7kasper/LazerGamebox/hardware/reports/bom_preview.csv

Reference | Value | Footprint | LCSC Part # | Description | Qty
ANT401 | 868 spring | LazerGamebox_lcsc:ANT-TH_BW868SNX20-5Z6 | C496555 | BAT WIRELESS BW868SNX20-5Z6 spring antenna 868 MHz, THT pin | 1
ANT402 | GPS patch 18x18 | LazerGamebox_lcsc:ANT-TH_L18.0-W18.0_C9900026472 | C784395 | BAT WIRELESS BWGNSCNX18-18W4 ceramic patch antenna 1575 MHz, THT pin | 1
BT101,BT102 | 18650 | LazerGamebox_lcsc:BATTERY-SMD_18650-1S-L77.1-W20.7-1 | C2988620 | MYOUNG BH-18650-B1BA002 SMT 18650 holder, gold contacts | 2
C101,C121,C203-C205,C504,C508,C509,C511,C513,C514,C517 | 1uF | Capacitor_SMD:C_0603_1608Metric | C15849 | Unpolarized capacitor | 12
C102,C105,C108,C110,C115,C118-C120,C201,C207,C304,C403,C406,C506,C601 | 10uF | Capacitor_SMD:C_0805_2012Metric | C15850 | Unpolarized capacitor | 15
C103,C106,C114,C122,C202,C206,C208,C209,C305,C404,C407,C501-C503,C507,C602-C609,C611 | 100nF | Capacitor_SMD:C_0603_1608Metric | C14663 | Unpolarized capacitor | 24
C107,C109,C111,C112 | 22uF | Capacitor_SMD:C_0805_2012Metric | C45783 | Unpolarized capacitor | 4
C113,C510 | 1nF | Capacitor_SMD:C_0603_1608Metric | C1588 | Unpolarized capacitor | 2
C116,C512,C610 | 4.7uF | Capacitor_SMD:C_0603_1608Metric | C19666 | Unpolarized capacitor | 3
C117 | 47nF | Capacitor_SMD:C_0603_1608Metric | C1622 | Unpolarized capacitor | 1
C303,C505 | 470uF | Capacitor_SMD:CP_Elec_6.3x7.7 | C2858856 | 470 uF 10 V SMD electrolytic | 2
C405,C516 | 100pF | Capacitor_SMD:C_0603_1608Metric | C14858 | Unpolarized capacitor | 2
D101 | USBLC6-2SC6 | Package_TO_SOT_SMD:SOT-23-6 | C7519 | Very low capacitance ESD protection diode, 2 data-line, SOT-23-6 | 1
D102 | RED CHRG | LED_SMD:LED_0603_1608Metric | C2286 | KENTO KT-0603R red LED | 1
D601-D603 | WS2812B-2020 | LazerGamebox:LED_WS2812B-2020_PLCC4_2.0x2.0mm | C52917434 | Worldsemi WS2812B-2020-V6 addressable RGB LED | 3
D604 | VSMY2940G | LazerGamebox_lcsc:LED-SMD_L2.3-W2.3-RD_VSMY2940G | C499547 | Vishay VSMY2940G 940 nm IR emitter, 75 mW/sr at 100 mA | 1
D605,D606 | SS34 | Diode_SMD:D_SMA | C8678 | Schottky diode | 2
J101 | USB-C 16P | LazerGamebox:USB_C_Receptacle_HRO_TYPE-C-31-M-12 | C165948 | Korean Hroparts TYPE-C-31-M-12, 16 pin USB 2.0 receptacle | 1
J301 | SMA | LazerGamebox:SMA_BAT_Wireless_BWSMA-KWE-Z001 | C496551 | BAT WIRELESS BWSMA-KWE-Z001 right-angle SMA, THT | 1
J601 | ZIF 12P 0.5mm | LazerGamebox_lcsc:FPC-SMD_12P-P0.50_05A20H12P | C5362174 | HanElectricity 05A20H12P dual-contact ZIF for HS20HS072RX (C5329582) panel | 1
J602 | EXPANSION 2x10 | Connector_PinHeader_2.54mm:PinHeader_2x10_P2.54mm_Vertical | C5383109 | HanElectricity 2541WV-2x10P 2.54 mm pin header, THT | 1
L101-L103 | 1uH | Inductor_SMD:L_Sunlord_SWPA4030S | C42193 | Sunlord SWPA4030S1R0NT 1 uH, Isat 5.7 A | 3
LS501 | FS-3013 30mm 8R | LazerGamebox_lcsc:BEEP-TH_BD30.0-P15.00-D1.0 | C482323 | FUET FS-3013 30 mm 8 ohm 1 W speaker, THT | 1
MK501 | MSM421ACT006 | LazerGamebox_lcsc:MIC-SMD_4P-L2.8-W1.9-P1.01-TL | C51928207 | MEMSensing MSM421ACT006 analog top-port MEMS microphone, -42 dBV/Pa, 1.5 to 3.6 V, LGA-4 | 1
Q101 | FS8205A | Package_TO_SOT_SMD:SOT-23-6 | C908265 | FUXINSEMI FS8205A dual N-channel MOSFET 20 V 6 A, common drain, SOT-23-6 | 1
Q103,Q105,Q107 | AO3401A | Package_TO_SOT_SMD:SOT-23 | C15127 | -4.0A Id, -30V Vds, P-Channel MOSFET, SOT-23 | 3
Q104,Q106,Q108,Q301,Q501 | 2N7002 | Package_TO_SOT_SMD:SOT-23 | C8545 | 0.115A Id, 60V Vds, N-Channel MOSFET, SOT-23,2N7002 N-MOSFET, mic mute | 5
Q201,Q202,Q601,Q602 | SS8050 | Package_TO_SOT_SMD:SOT-23 | C2150 | General Purpose NPN Transistor, 1.5A Ic, 25V Vce, SOT-23 | 4
Q603,Q604 | AO3400A | Package_TO_SOT_SMD:SOT-23 | C20917 | AOS AO3400A N-MOSFET 5.7 A, 30 mR, low-side driver | 2
R101-R103,R105,R116,R118,R120,R122,R201-R205,R208,R302,R410,R510,R511,R521,R603,R606,R609,R610 | 10k | Resistor_SMD:R_0603_1608Metric | C25804 | Resistor | 23
R104,R107,R210,R211,R306,R411,R501,R506,R512,R516,R602 | 1k | Resistor_SMD:R_0603_1608Metric | C21190 | Resistor | 11
R106,R605 | 100R | Resistor_SMD:R_0603_1608Metric | C22775 | Resistor | 2
R111 | 150k | Resistor_SMD:R_0603_1608Metric | C22807 | Resistor | 1
R112,R114 | 33k | Resistor_SMD:R_0603_1608Metric | C4216 | Resistor | 2
R113,R502,R503 | 220k | Resistor_SMD:R_0603_1608Metric | C22961 | Resistor | 3
R115,R117,R119,R304,R305,R504,R505,R508,R509,R517-R519 | 100k | Resistor_SMD:R_0603_1608Metric | C25803 | Resistor | 12
R121,R206,R207,R513,R514 | 4.7k | Resistor_SMD:R_0603_1608Metric | C23162 | Resistor | 5
R123,R209,R301,R401,R412 | 0R | Resistor_SMD:R_0603_1608Metric | C21189 | Resistor | 5
R125,R126,R604,R608 | 330R | Resistor_SMD:R_0603_1608Metric | C23138 | Resistor | 4
R303,R515 | 22k | Resistor_SMD:R_0603_1608Metric | C31850 | Resistor | 2
R507 | 47k | Resistor_SMD:R_0603_1608Metric | C25819 | Resistor | 1
R520 | 470k | Resistor_SMD:R_0603_1608Metric | C23164 | Resistor | 1
R601 | 20R | Resistor_SMD:R_0805_2012Metric | C17544 | Resistor | 1
R607 | 12R | Resistor_SMD:R_1206_3216Metric | C17913 | Resistor | 1
RV601 | 10k lin | LazerGamebox_lcsc:Potentiometer_Alps_RK09K1130A6S_LCSC | C209770 | Alps RK09K1130A6S 10k linear, 15 mm flat shaft, THT | 1
SW101 | PWR | LazerGamebox:SW_Push_1P1T_XKB_TS-1187A | C318884 | XKB TS-1187A-B-A-B 5.1 mm tact switch | 1
SW201 | RESET | LazerGamebox:SW_Push_1P1T_XKB_TS-1187A | C318884 | XKB TS-1187A-B-A-B 5.1 mm tact switch | 1
SW202 | BOOT | LazerGamebox:SW_Push_1P1T_XKB_TS-1187A | C318884 | XKB TS-1187A-B-A-B 5.1 mm tact switch | 1
SW601 | BTN1 | LazerGamebox:SW_Push_1P1T_XKB_TS-1187A | C318884 | XKB TS-1187A-B-A-B 5.1 mm tact switch | 1
SW602 | BTN2 | LazerGamebox:SW_Push_1P1T_XKB_TS-1187A | C318884 | XKB TS-1187A-B-A-B 5.1 mm tact switch | 1
SW603 | BTN3 | LazerGamebox:SW_Push_1P1T_XKB_TS-1187A | C318884 | XKB TS-1187A-B-A-B 5.1 mm tact switch | 1
U101 | BQ25601 | LazerGamebox_lcsc:VFQFPN-24_L4.0-W4.0-P0.50-BL-EP2.8 | C468236 | TI BQ25601 3 A I2C 1S switching charger with NVDC power path and ship mode, WQFN-24 | 1
U102 | DW01A | Package_TO_SOT_SMD:SOT-23-6 | C351410 | PUOLOP DW01A single cell protection IC | 1
U103 | TPS62A02 | Package_TO_SOT_SMD:SOT-563 | C5350187 | TI TPS62A02DRLR 2 A synchronous buck, SOT-563 | 1
U104 | TPS61023 | Package_TO_SOT_SMD:SOT-563 | C919459 | TI TPS61023 synchronous boost converter, 3.7 A switch, true disconnect, SOT-563 | 1
U105 | HUSB238 | LazerGamebox_lcsc:DFN-10_L3.0-W3.0-P0.50-BL-EP2.5 | C7471904 | Hynetek HUSB238 USB PD sink controller with I2C source-capability readback, DFN-10 | 1
U106 | MAX17048 | LazerGamebox_lcsc:TDFN-8_L2.0-W2.0-P0.50-BL-EP1.2 | C2682616 | Maxim MAX17048 ModelGauge 1S fuel gauge, I2C 0x36, TDFN-8 2x2 | 1
U201 | ESP32-WROOM-32E-N16 | RF_Module:ESP32-WROOM-32E | C701343 | Espressif ESP32-WROOM-32E-N16 module | 1
U202 | XC6206P332MR | Package_TO_SOT_SMD:SOT-23-3 | C5446 | Torex XC6206P332MR 3.3 V 250 mA LDO | 1
U203 | CH340C | Package_SO:SOIC-16_3.9x9.9mm_P1.27mm | C84681 | WCH CH340C USB to UART bridge with internal oscillator, SOIC-16 | 1
U204 | LIS3DHTR | Package_LGA:LGA-16_3x3mm_P0.5mm_LayoutBorder3x5y | C15134 | ST LIS3DHTR 3-axis accelerometer, LGA-16 | 1
U205,U602 | TCA9555PWR | Package_SO:TSSOP-24_4.4x7.8mm_P0.65mm | C465732 | TI TCA9555PWR 16-bit I2C GPIO expander with interrupt | 2
U301 | SA818S-U | LazerGamebox_lcsc:WIRELM-SMD_G-NICERF_SA818S-X | C3001549 | G-NiceRF SA818S-U 1 W UHF walkie-talkie module, 400-480 MHz, UART control | 1
U401 | Ra-01SH | LazerGamebox_lcsc:WIRELM-SMD_RA-01SH | C2764087 | Ai-Thinker Ra-01SH SX1262 LoRa module 803-930 MHz, SPI | 1
U402 | ATGM336H-5N31 | LazerGamebox_lcsc:GPSM-SMD_ATGM336H-TR | C90770 | ZHONGKEWEI ATGM336H-5N31 GNSS module (GPS/BDS/GLONASS), UART, 1PPS | 1
U501,U503 | TS5A3159 | Package_TO_SOT_SMD:SOT-363_SC-70-6 | C46388 | TI TS5A3159 1 ohm SPDT analog switch, SC-70-6 | 2
U502 | NS4150B | Package_SO:MSOP-8_3x3mm_P0.65mm | C189961 | Nsiway NS4150B 3 W mono class-D audio amplifier, MSOP-8 | 1
U504 | LMV321 | Package_TO_SOT_SMD:SOT-23-5 | C7972 | TI LMV321 rail-to-rail op amp, 1 MHz GBW, SOT-23-5 | 1
U601 | IRM-H638T | LazerGamebox:Everlight_IRM-H6xxT | C91447 | Everlight IRM-H638T/TR2 38 kHz IR receiver module, SMD | 1
