7kasper/LazerGamebox/hardware/reports/LazerGamebox_schematic.pdf

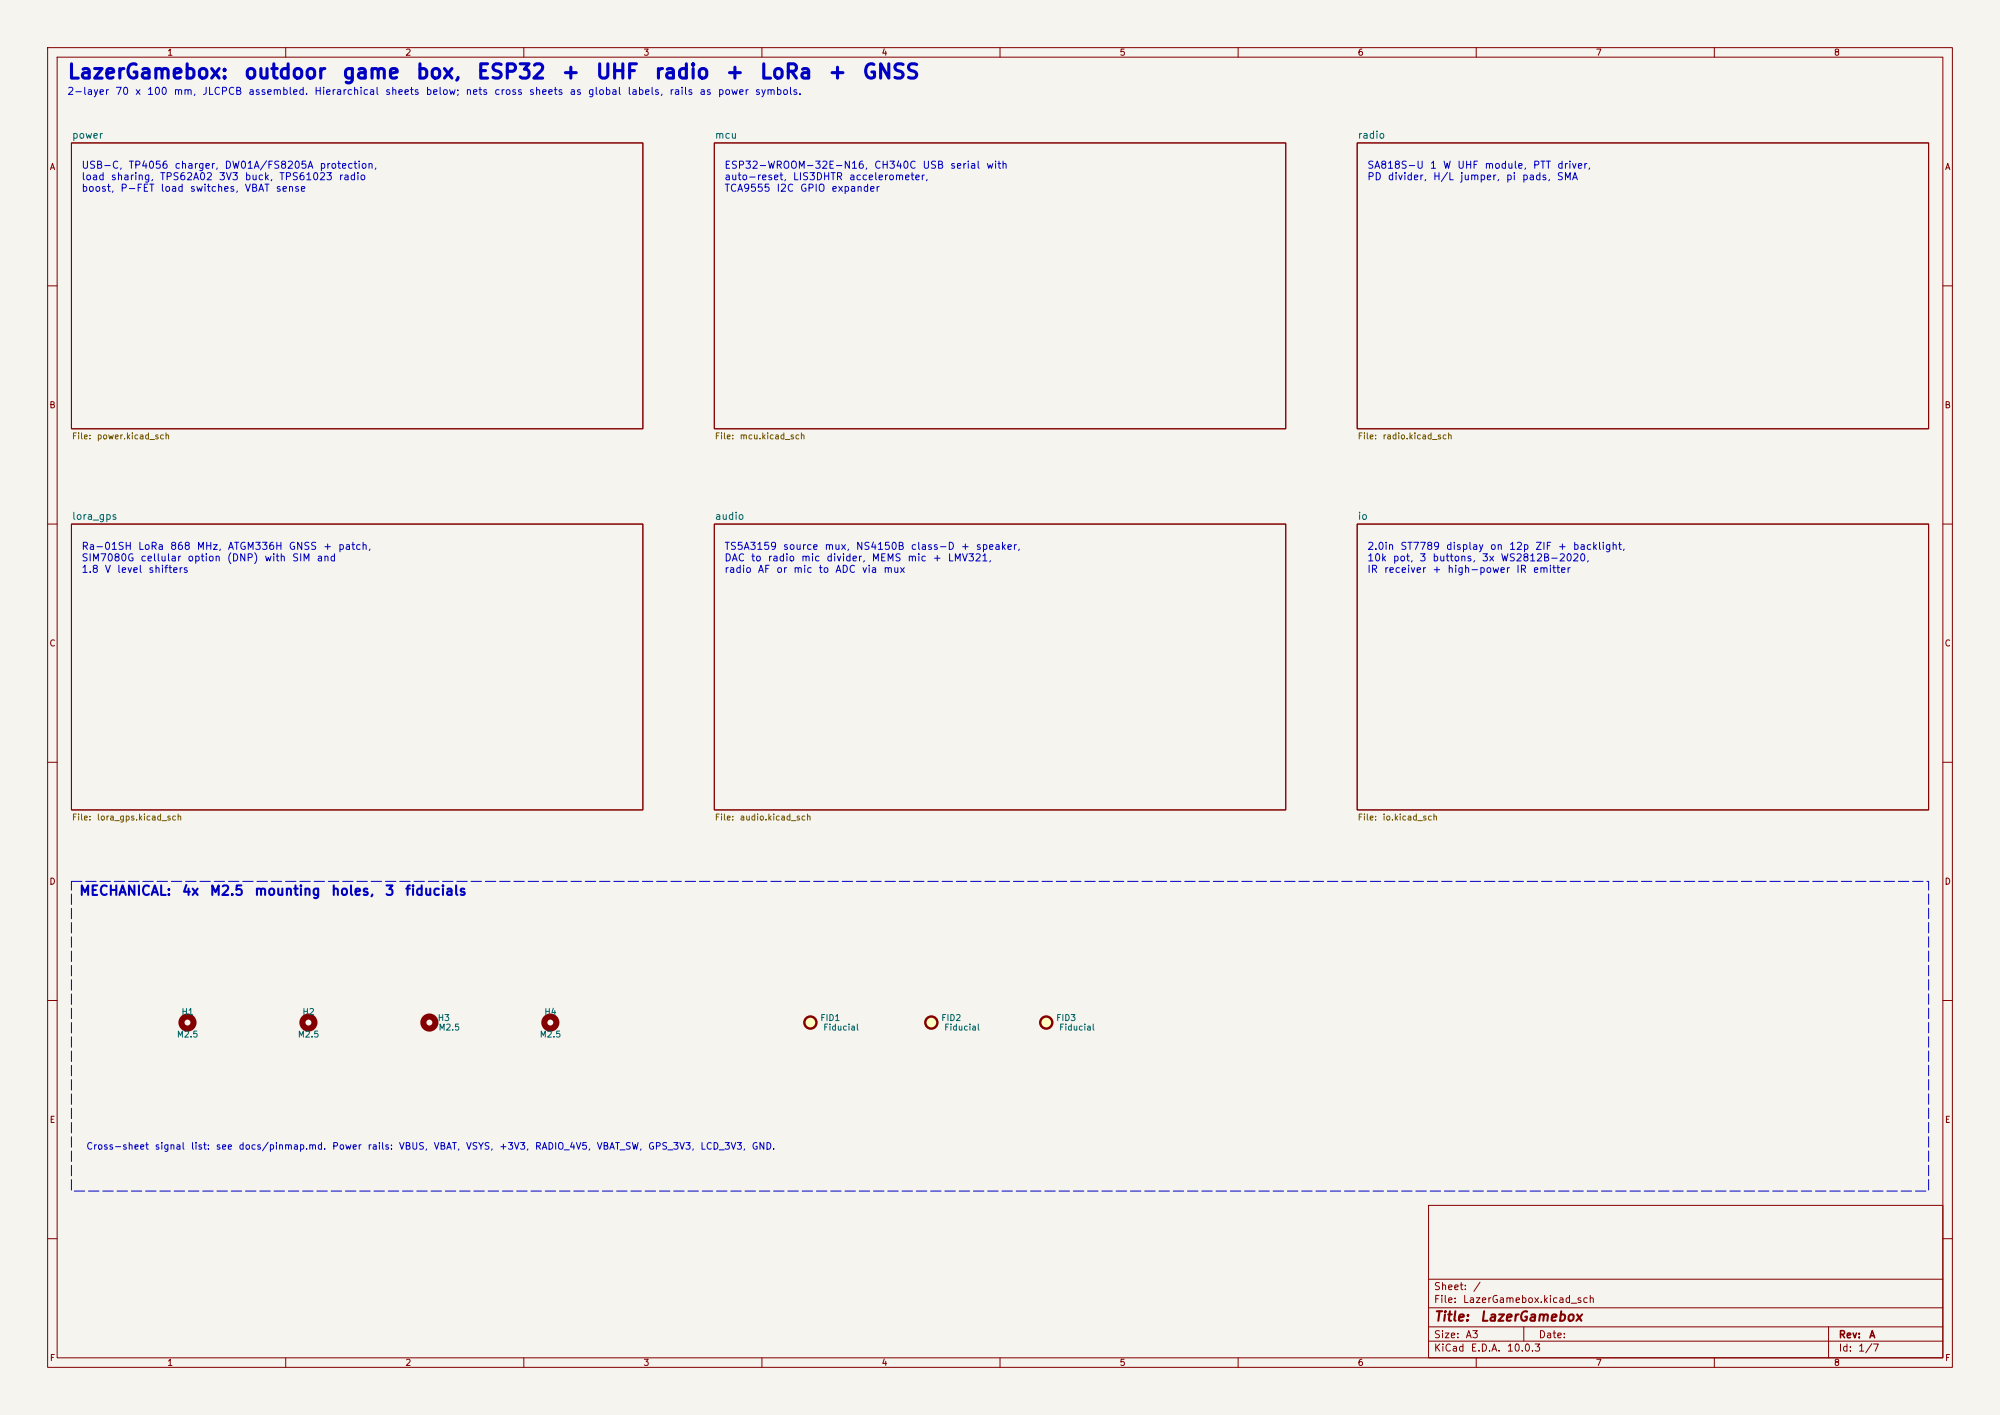
[picture p1: page 1]

LazerGamebox: outdoor game box, ESP32 + UHF radio + LoRa + GNSS

2-layer 70 x 100 mm, JLCPCB assembled. Hierarchical sheets below; nets cross sheets as global labels, rails as power symbols.

USB-C, TP4056 charger, DW01A/FS8205A protection,
load sharing, TPS62A02 3V3 buck, TPS61023 radio

SA818S-U 1 W UHF module, PTT driver,
PD divider, H/L jumper, pi pads, SMA

Ra-01SH LoRa 868 MHz, ATGM336H GNSS + patch,
SIM7080G cellular option (DNP) with SIM and
1.8 V level shifters

TS5A3159 source mux, NS4150B class-D + speaker,
DAC to radio mic divider, MEMS mic + LMV321,

10k pot, 3 buttons, 3x WS2812B-2020,
IR receiver + high-power IR emitter

MECHANICAL: 4x M2.5 mounting holes, 3 fiducials

Cross-sheet signal list: see docs/pinmap.md. Power rails: VBUS, VBAT, VSYS, +3V3, RADIO_4V5, VBAT_SW, GPS_3V3, LCD_3V3, GND.

Size: A3 | Rev: A | F Date:
KiCad E.D.A. 10.0.3 | Id: 1/7

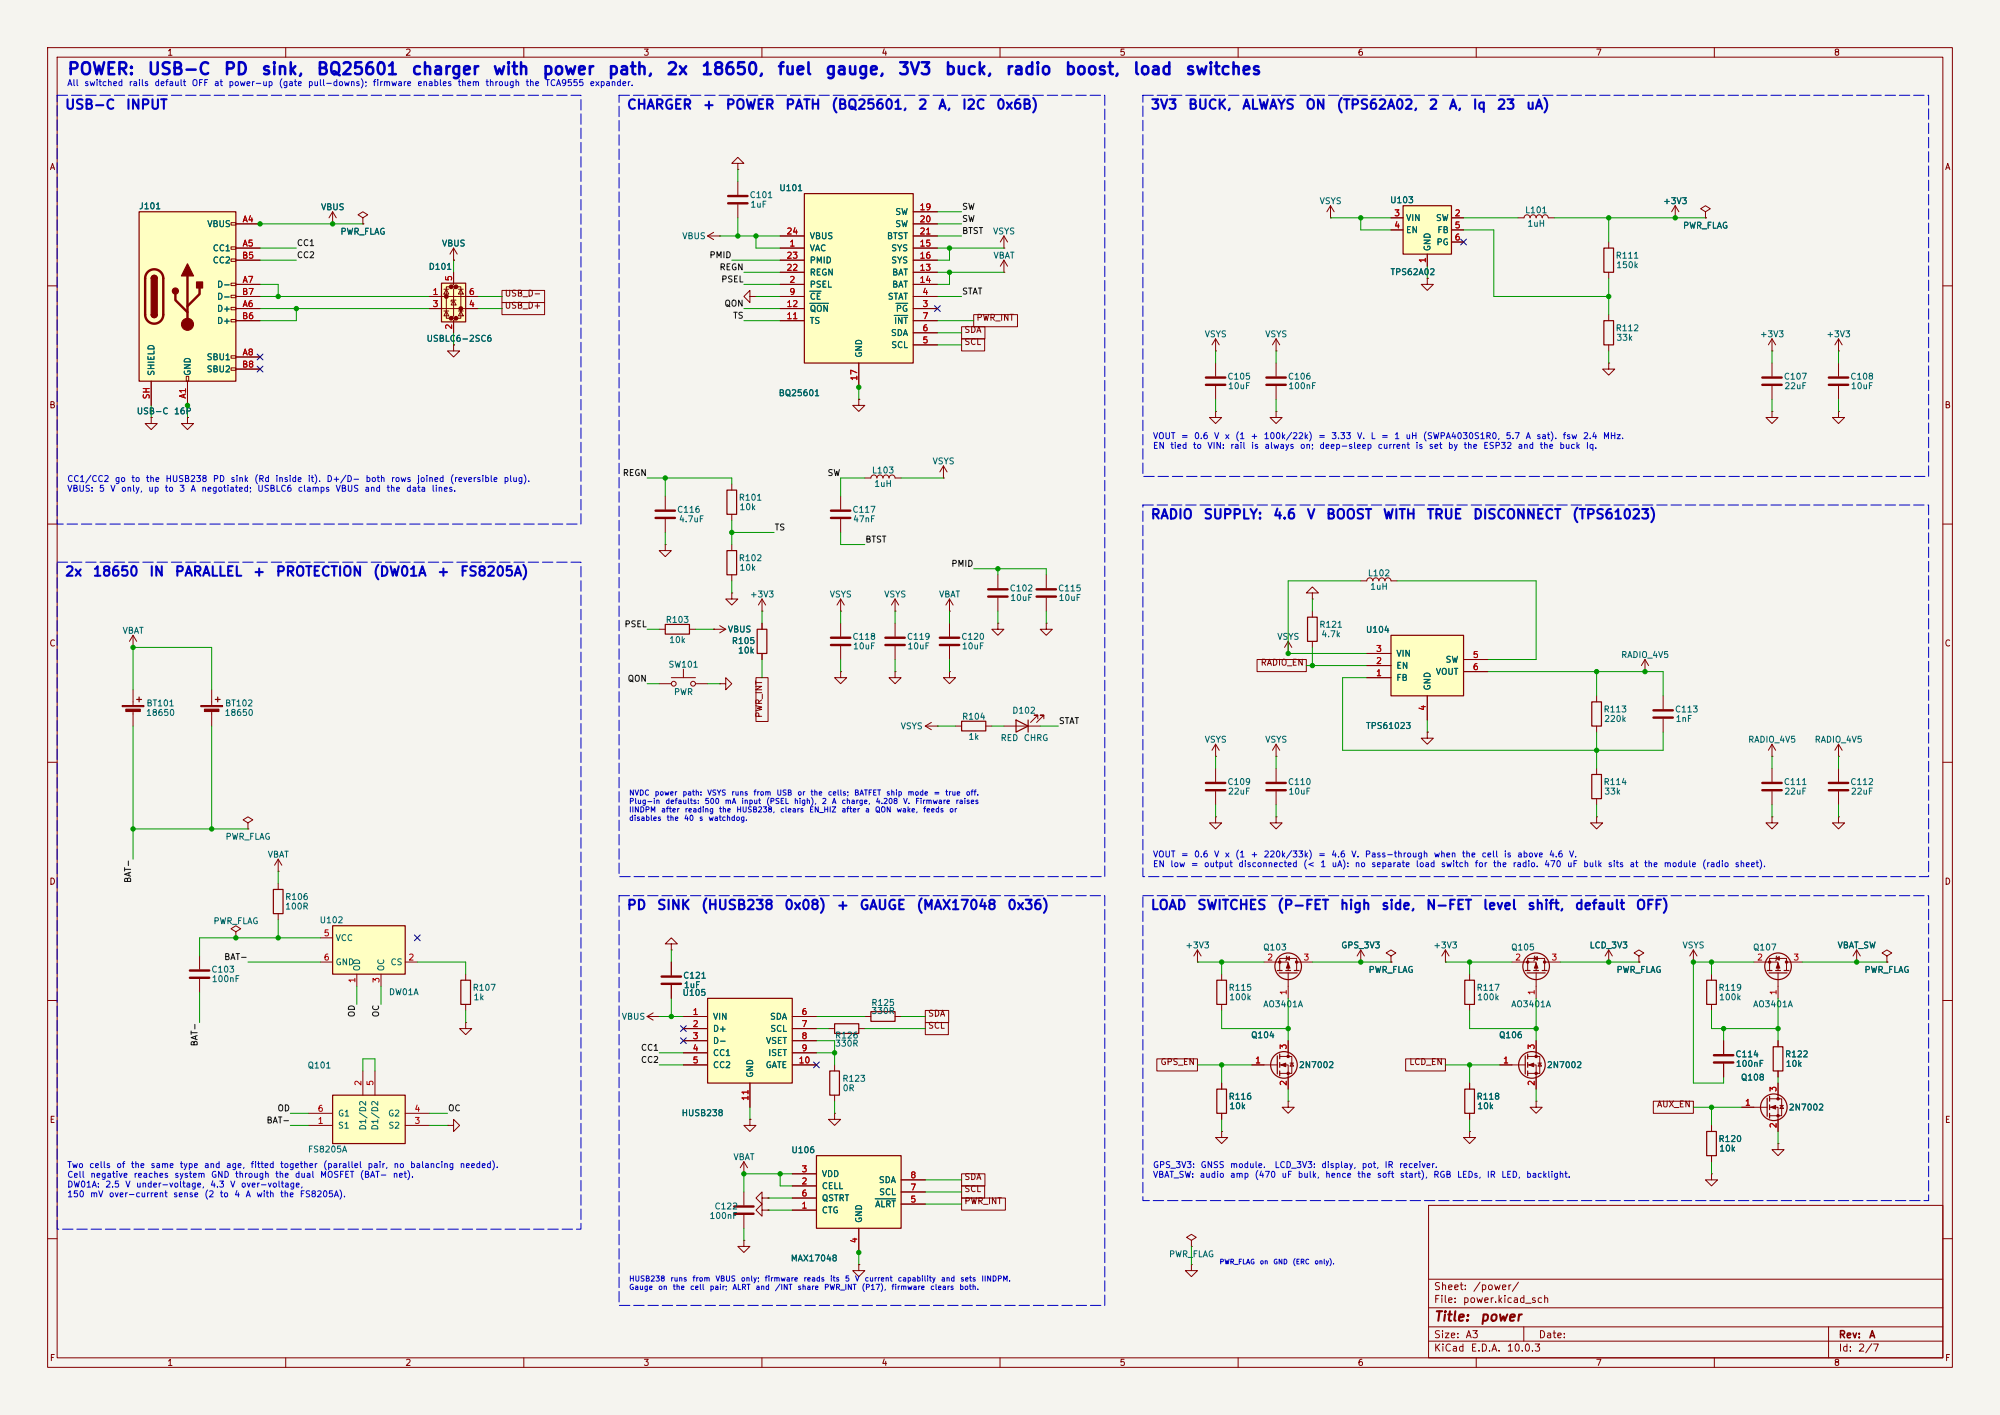
[picture p2: page 2]

POWER: USB-C PD sink, BQ25601 charger with power path, 2x 18650, fuel gauge, 3V3 buck, radio boost, load switches
All switched rails default OFF at power-up (gate pull-downs); firmware enables them through the TCA9555 expander.
USB-C INPUT
J101 USB-C 16P

3V3 BUCK, ALWAYS ON (TPS62A02, 2 A, Iq 23 uA)

VOUT = 0.6 V x (1 + 100k/22k) = 3.33 V. L = 1 uH (SWPA4030S1R0, 5.7 A sat). fsw 2.4 MHz. EN tied to VIN: rail is always on; deep-sleep current is set by the ESP32 and the buck Iq.

CC1/CC2 go to the HUSB238 PD sink (Rd inside it). D+/D- both rows joined (reversible plug). VBUS: 5 V only, up to 3 A negotiated; USBLC6 clamps VBUS and the data lines. 2x 18650 IN PARALLEL + PROTECTION (DW01A + FS8205A)

RADIO SUPPLY: 4.6 V BOOST WITH TRUE DISCONNECT (TPS61023)

NVDC power path: VSYS runs from USB or the cells; BATFET ship mode = true off. Plug-in defaults: 500 mA input (PSEL high), 2 A charge, 4.208 V. Firmware raises

IINDPM after reading the HUSB238, clears EN_HIZ after a QON wake, feeds or disables the 40 s watchdog.

VOUT = 0.6 V x (1 + 220k/33k) = 4.6 V. Pass-through when the cell is above 4.6 V. EN low = output disconnected (< 1 uA): no separate load switch for the radio. 470 uF bulk sits at the module (radio sheet).

LOAD SWITCHES (P-FET high side, N-FET level shift, default OFF)

GPS_3V3: GNSS module. LCD_3V3: display, pot, IR receiver. VBAT_SW: audio amp (470 uF bulk, hence the soft start), RGB LEDs, IR LED, backlight.

HUSB238 runs from VBUS only; firmware reads its 5 V current capability and sets IINDPM. Gauge on the cell pair; ALRT and /INT share PWR_INT (P17), firmware clears both.

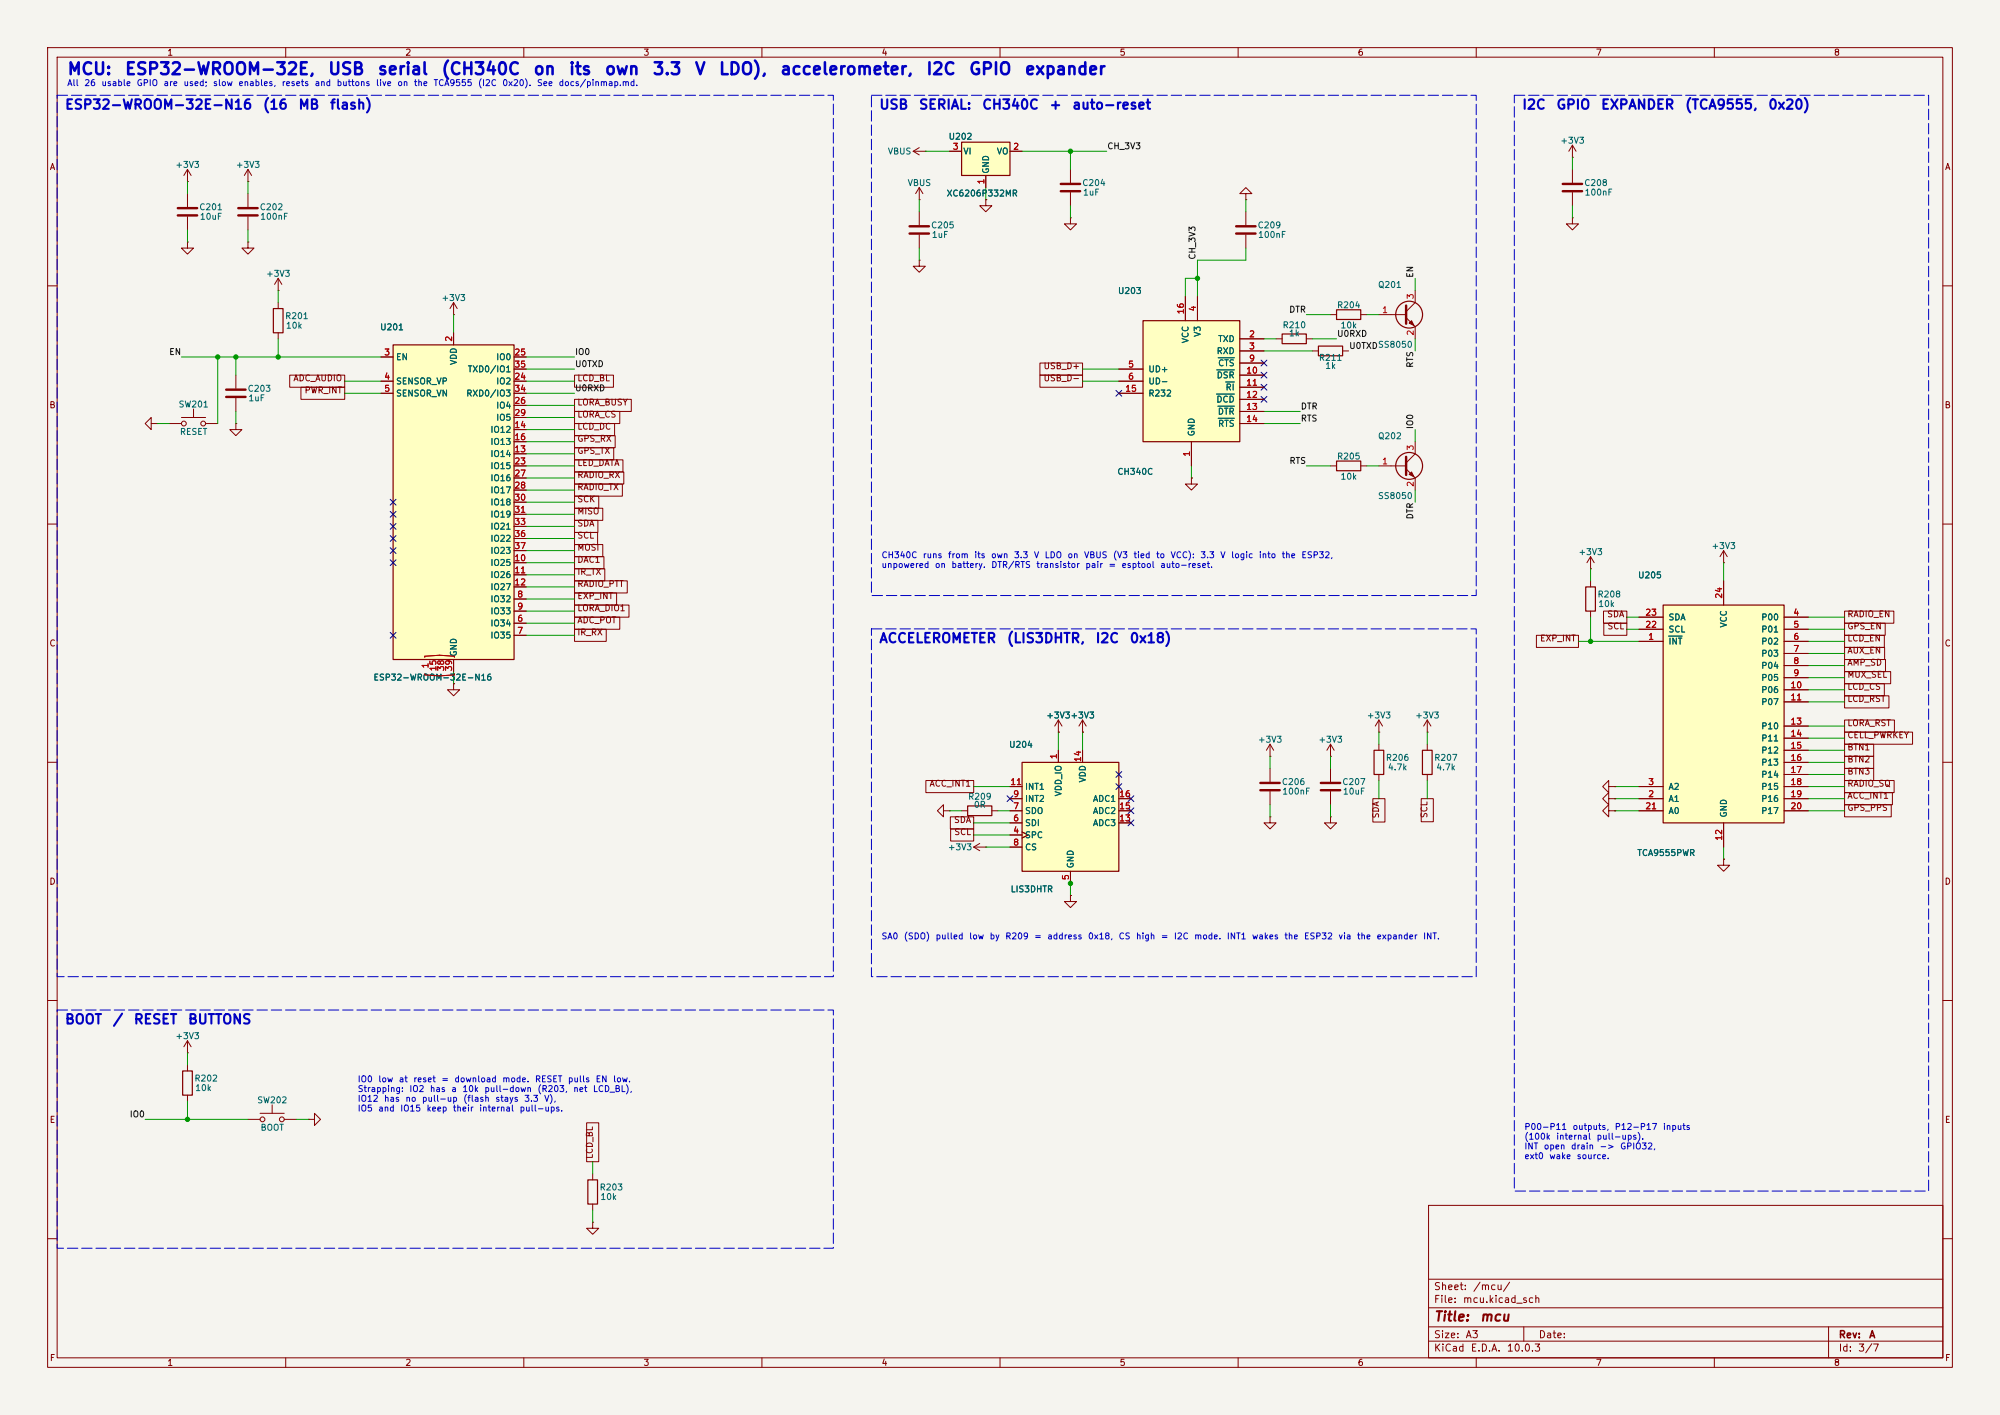
[picture p3: page 3]

MCU: ESP32-WROOM-32E, USB serial (CH340C on its own 3.3 V LDO), accelerometer, I2C GPIO expander
All 26 usable GPIO are used; slow enables, resets and buttons live on the TCA9555 (I2C 0x20). See docs/pinmap.md.

USB SERIAL: CH340C + auto-reset

4 UD+ 5 UD- 6 CTS 9 DSR 10 RI 11 DCD 12 DTR 13 RTS 14 R232 15 VCC 16 U203 CH340C

4 UD+ 5 UD- 6 CTS 9 DSR 10 RI 11 DCD 12 DTR 13 RTS 14 R232 15 VCC 16 U204

CH340C runs from its own 3.3 V LDO on VBUS (V3 tied to VCC): 3.3 V logic into the ESP32,
unpowered on battery. DTR/RTS transistor pair = esptool auto-reset. ACCELEROMETER (LIS3DHTR, I2C 0x18)

SA0 (SDO) pulled low by R209 = address 0x18, CS high = I2C mode. INT1 wakes the ESP32 via the expander INT. BOOT / RESET BUTTONS

IO0 low at reset = download mode. RESET pulls EN low. Strapping: IO2 has a 10k pull-down (R203, net LCD_BL),

IO12 has no pull-up (flash stays 3.3 V),
IO5 and IO15 keep their internal pull-ups.

P00-P11 outputs, P12-P17 inputs
(100k internal pull-ups).
INT open drain -> GPIO32, ext0 wake source.

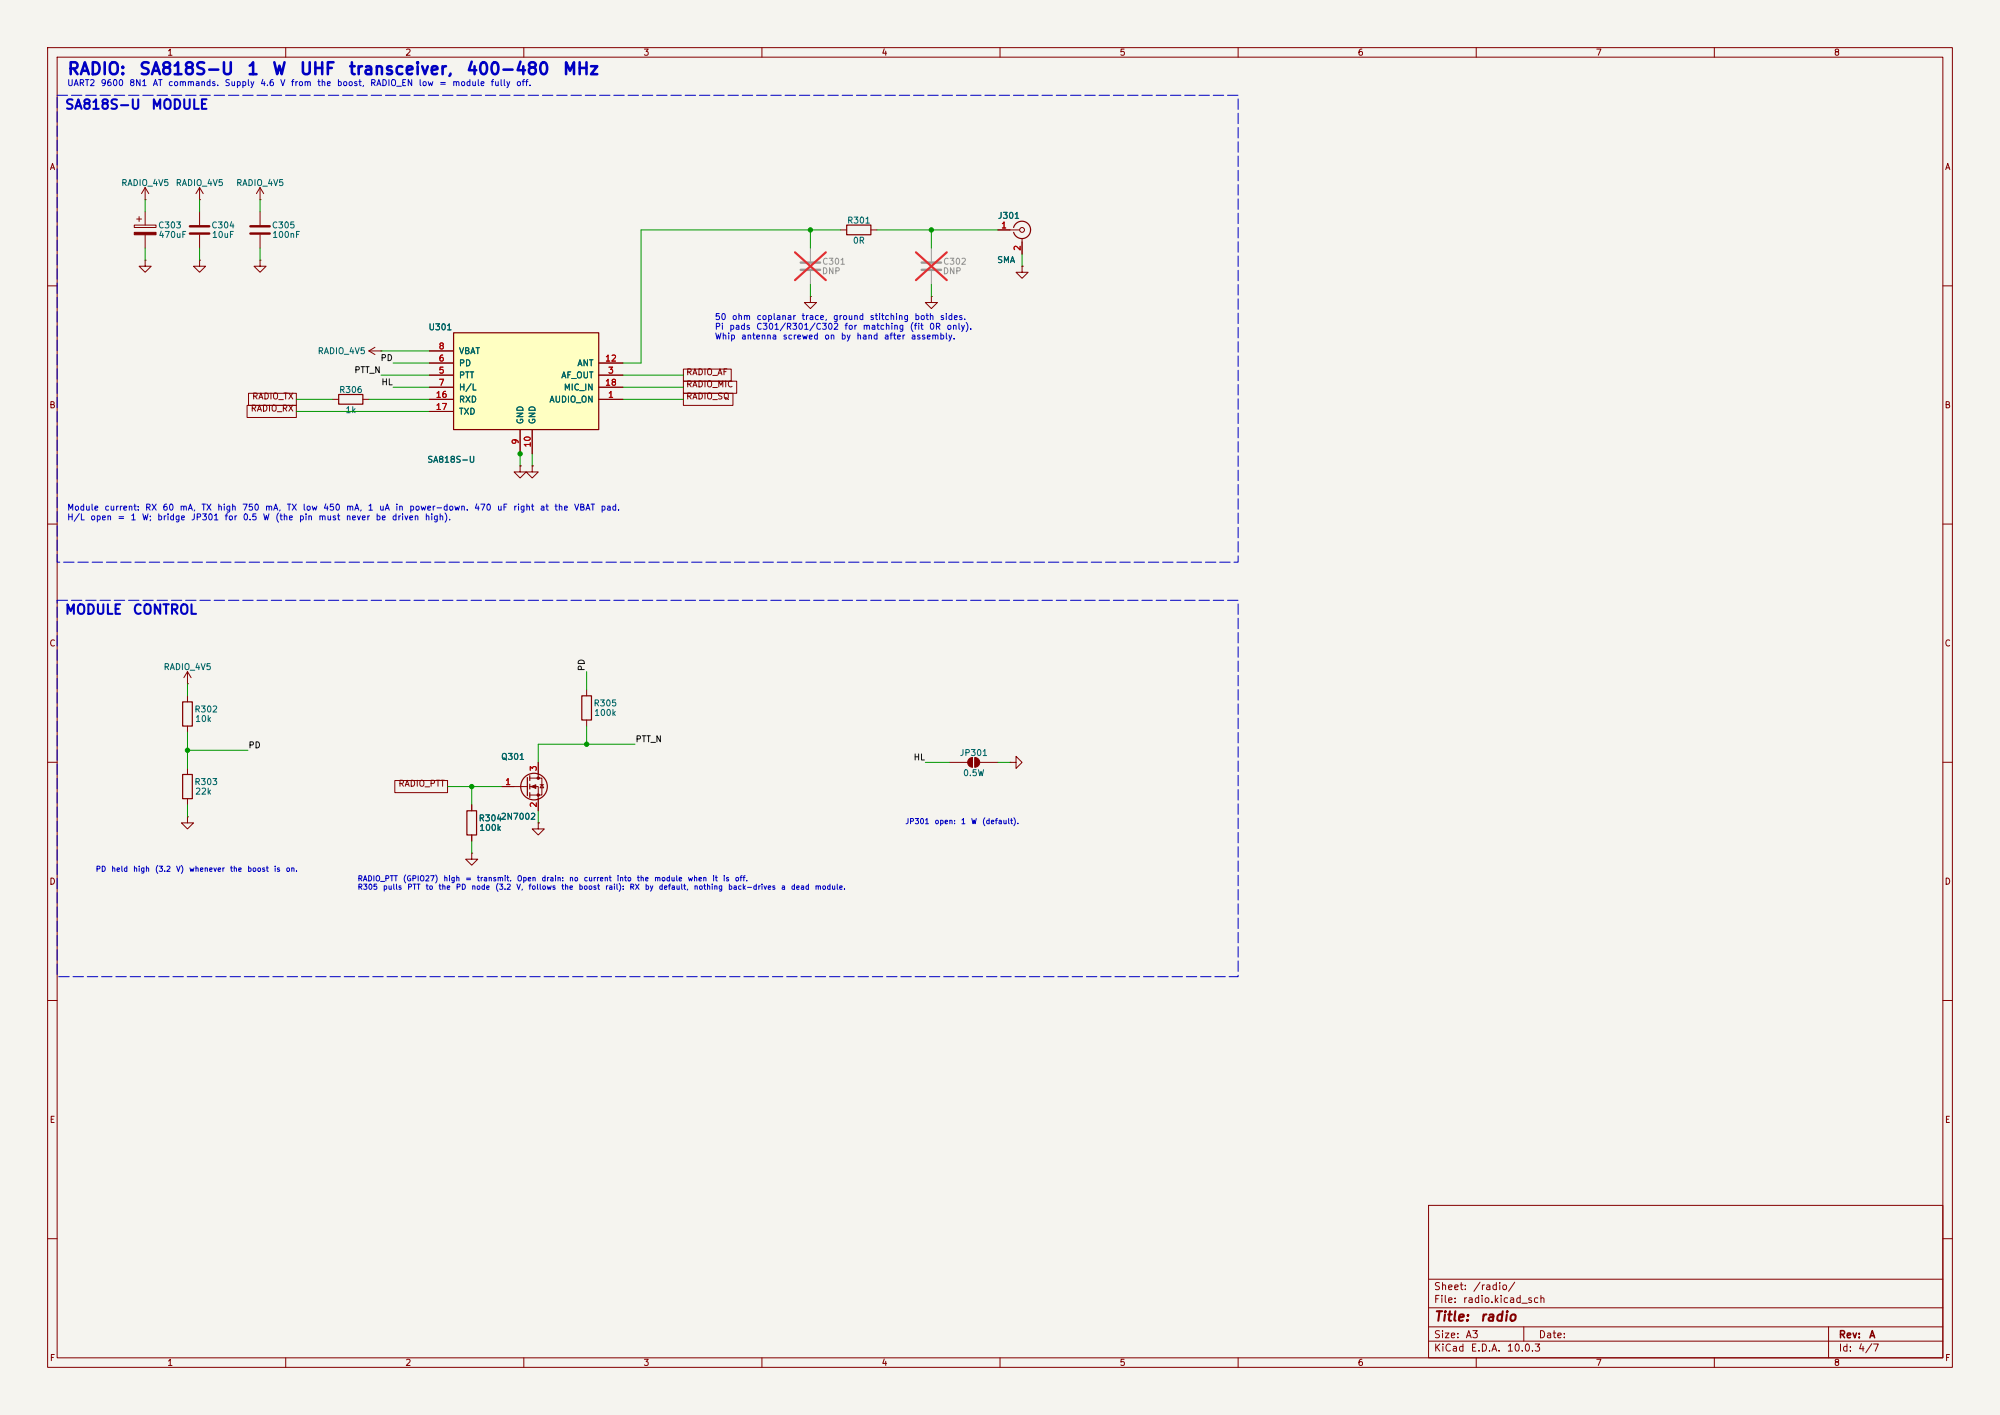
[picture p4: page 4]

RADIO: SA818S-U 1 W UHF transceiver, 400-480 MHz
UART2 9600 8N1 AT commands. Supply 4.6 V from the boost, RADIO_EN low = module fully off.
SA818S-U MODULE

50 ohm coplanar trace, ground stitching both sides. Pi pads C301/R301/C302 for matching (fit 0R only).

Whip antenna screwed on by hand after assembly.

Module current: RX 60 mA, TX high 750 mA, TX low 450 mA, 1 uA in power-down. 470 uF right at the VBAT pad.
H/L open = 1 W; bridge JP301 for 0.5 W (the pin must never be driven high).

JP301 open: 1 W (default). RADIO_PTT (GPIO27) high = transmit. Open drain: no current into the module when it is off. R305 pulls PTT to the PD node (3.2 V, follows the boost rail): RX by default, nothing back-drives a dead module.

PD held high (3.2 V) whenever the boost is on.

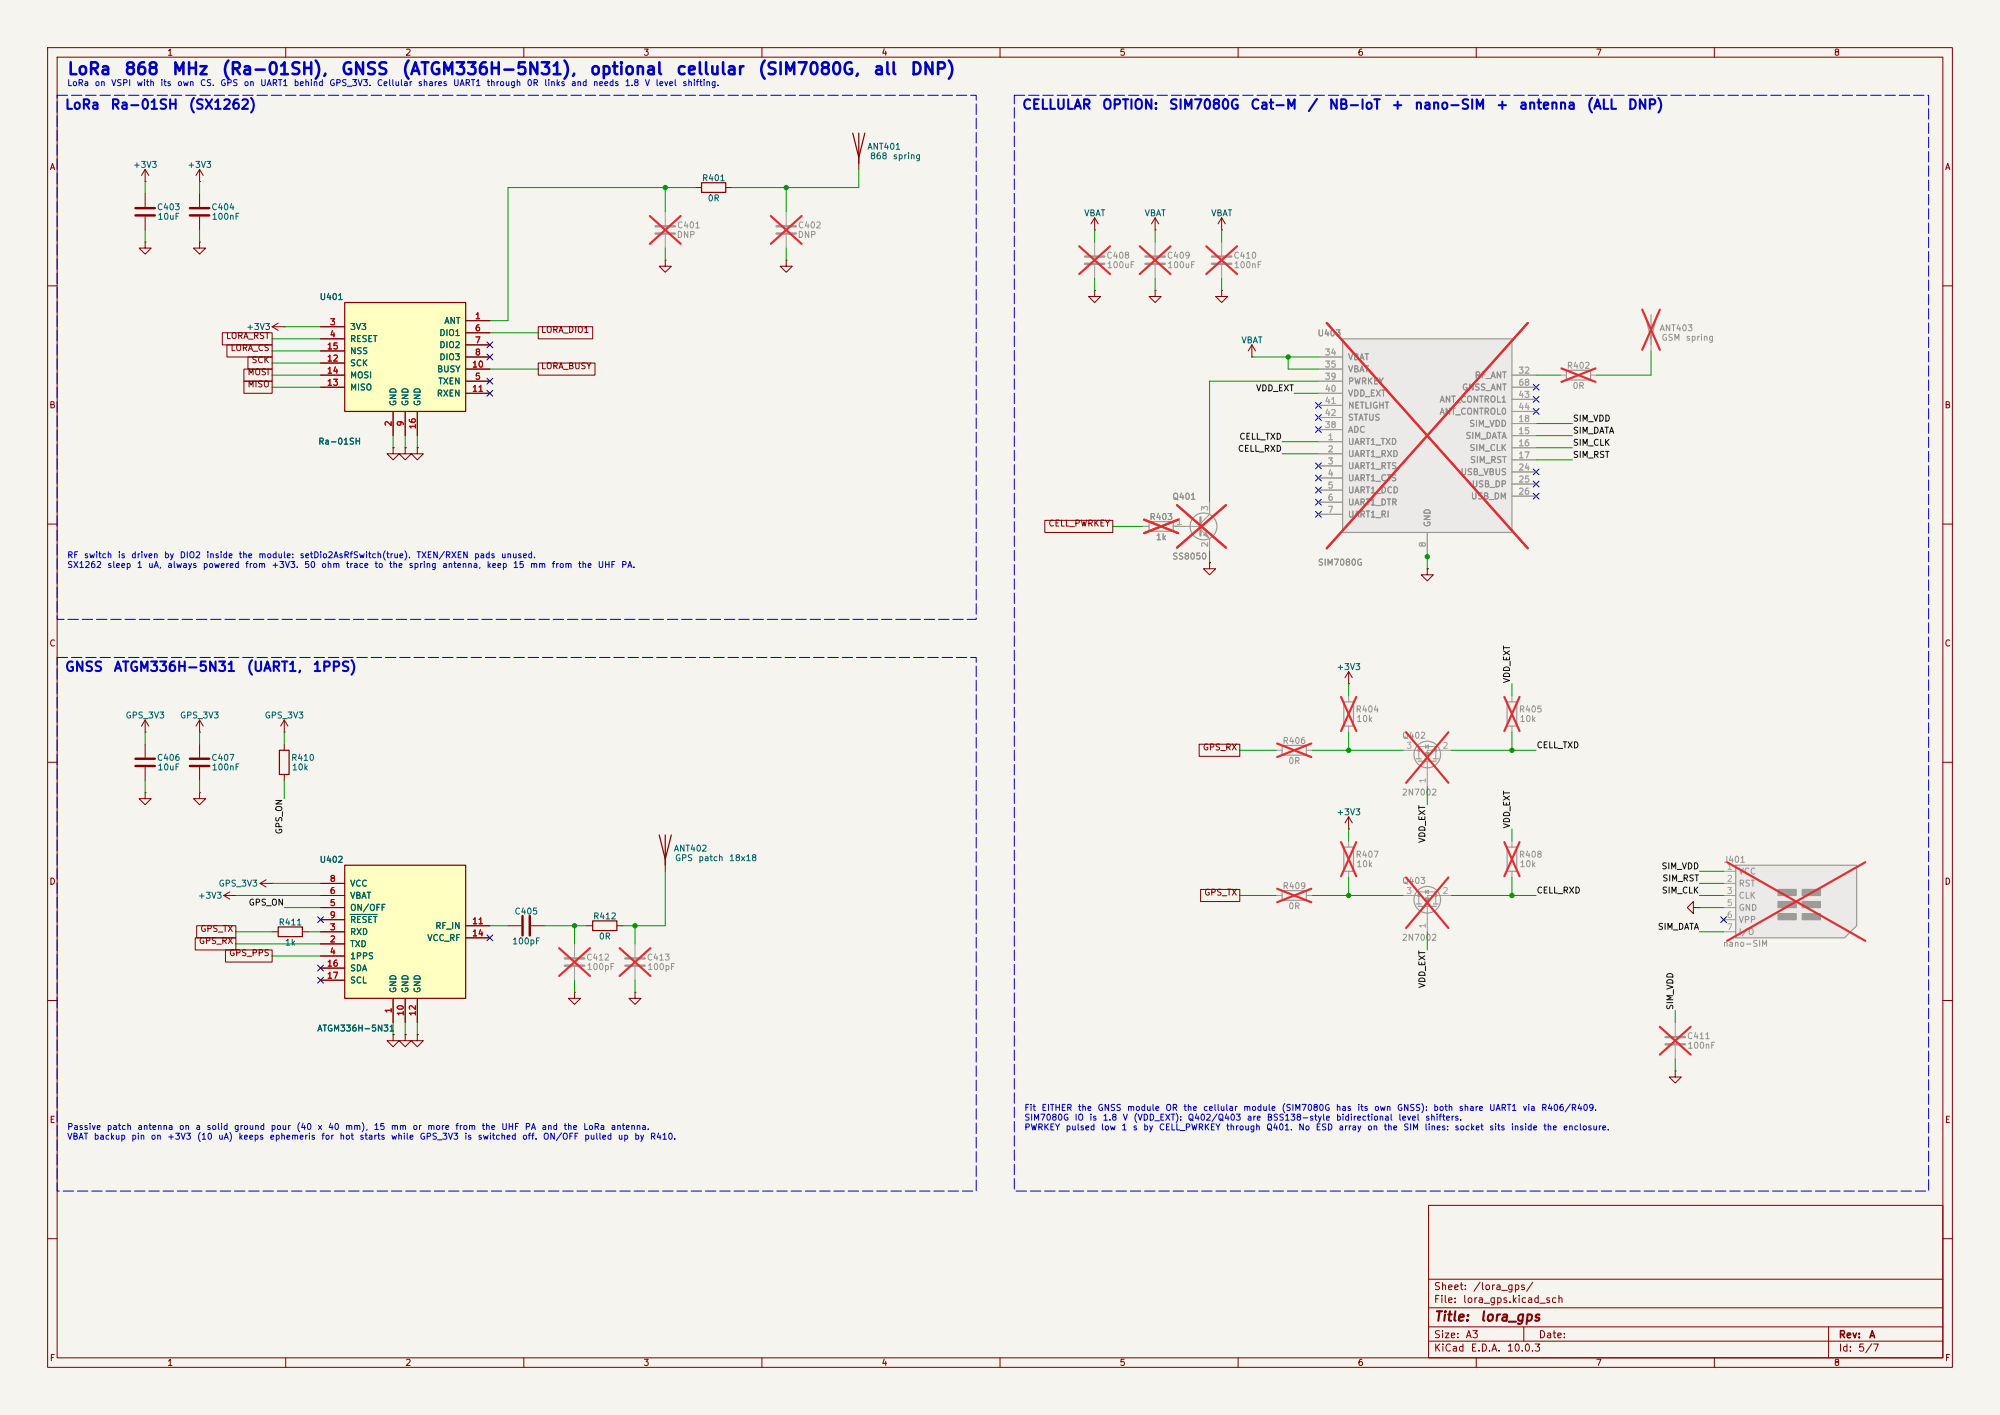
[picture p5: page 5]

LoRa 868 MHz (Ra-01SH), GNSS (ATGM336H-5N31), optional cellular (SIM7080G, all DNP)
LoRa on VSPI with its own CS. GPS on UART1 behind GPS_3V3. Cellular shares UART1 through 0R links and needs 1.8 V level shifting.
LoRa Ra-01SH (SX1262)

CELLULAR OPTION: SIM7080G Cat-M / NB-IoT + nano-SIM + antenna (ALL DNP)

RF switch is driven by DIO2 inside the module: setDio2AsRfSwitch(true). TXEN/RXEN pads unused. SX1262 sleep 1 uA, always powered from +3V3. 50 ohm trace to the spring antenna, keep 15 mm from the UHF PA. GNSS ATGM336H-5N31 (UART1, 1PPS)

Fit EITHER the GNSS module OR the cellular module (SIM7080G has its own GNSS): both share UART1 via R406/R409. SIM7080G IO is 1.8 V (VDD_EXT): Q402/Q403 are BSS138-style bidirectional level shifters. PWRKEY pulsed low 1 s by CELL_PWRKEY through Q401. No ESD array on the SIM lines: socket sits inside the enclosure.

Passive patch antenna on a solid ground pour (40 x 40 mm), 15 mm or more from the UHF PA and the LoRa antenna. VBAT backup pin on +3V3 (10 uA) keeps ephemeris for hot starts while GPS_3V3 is switched off. ON/OFF pulled up by R410.

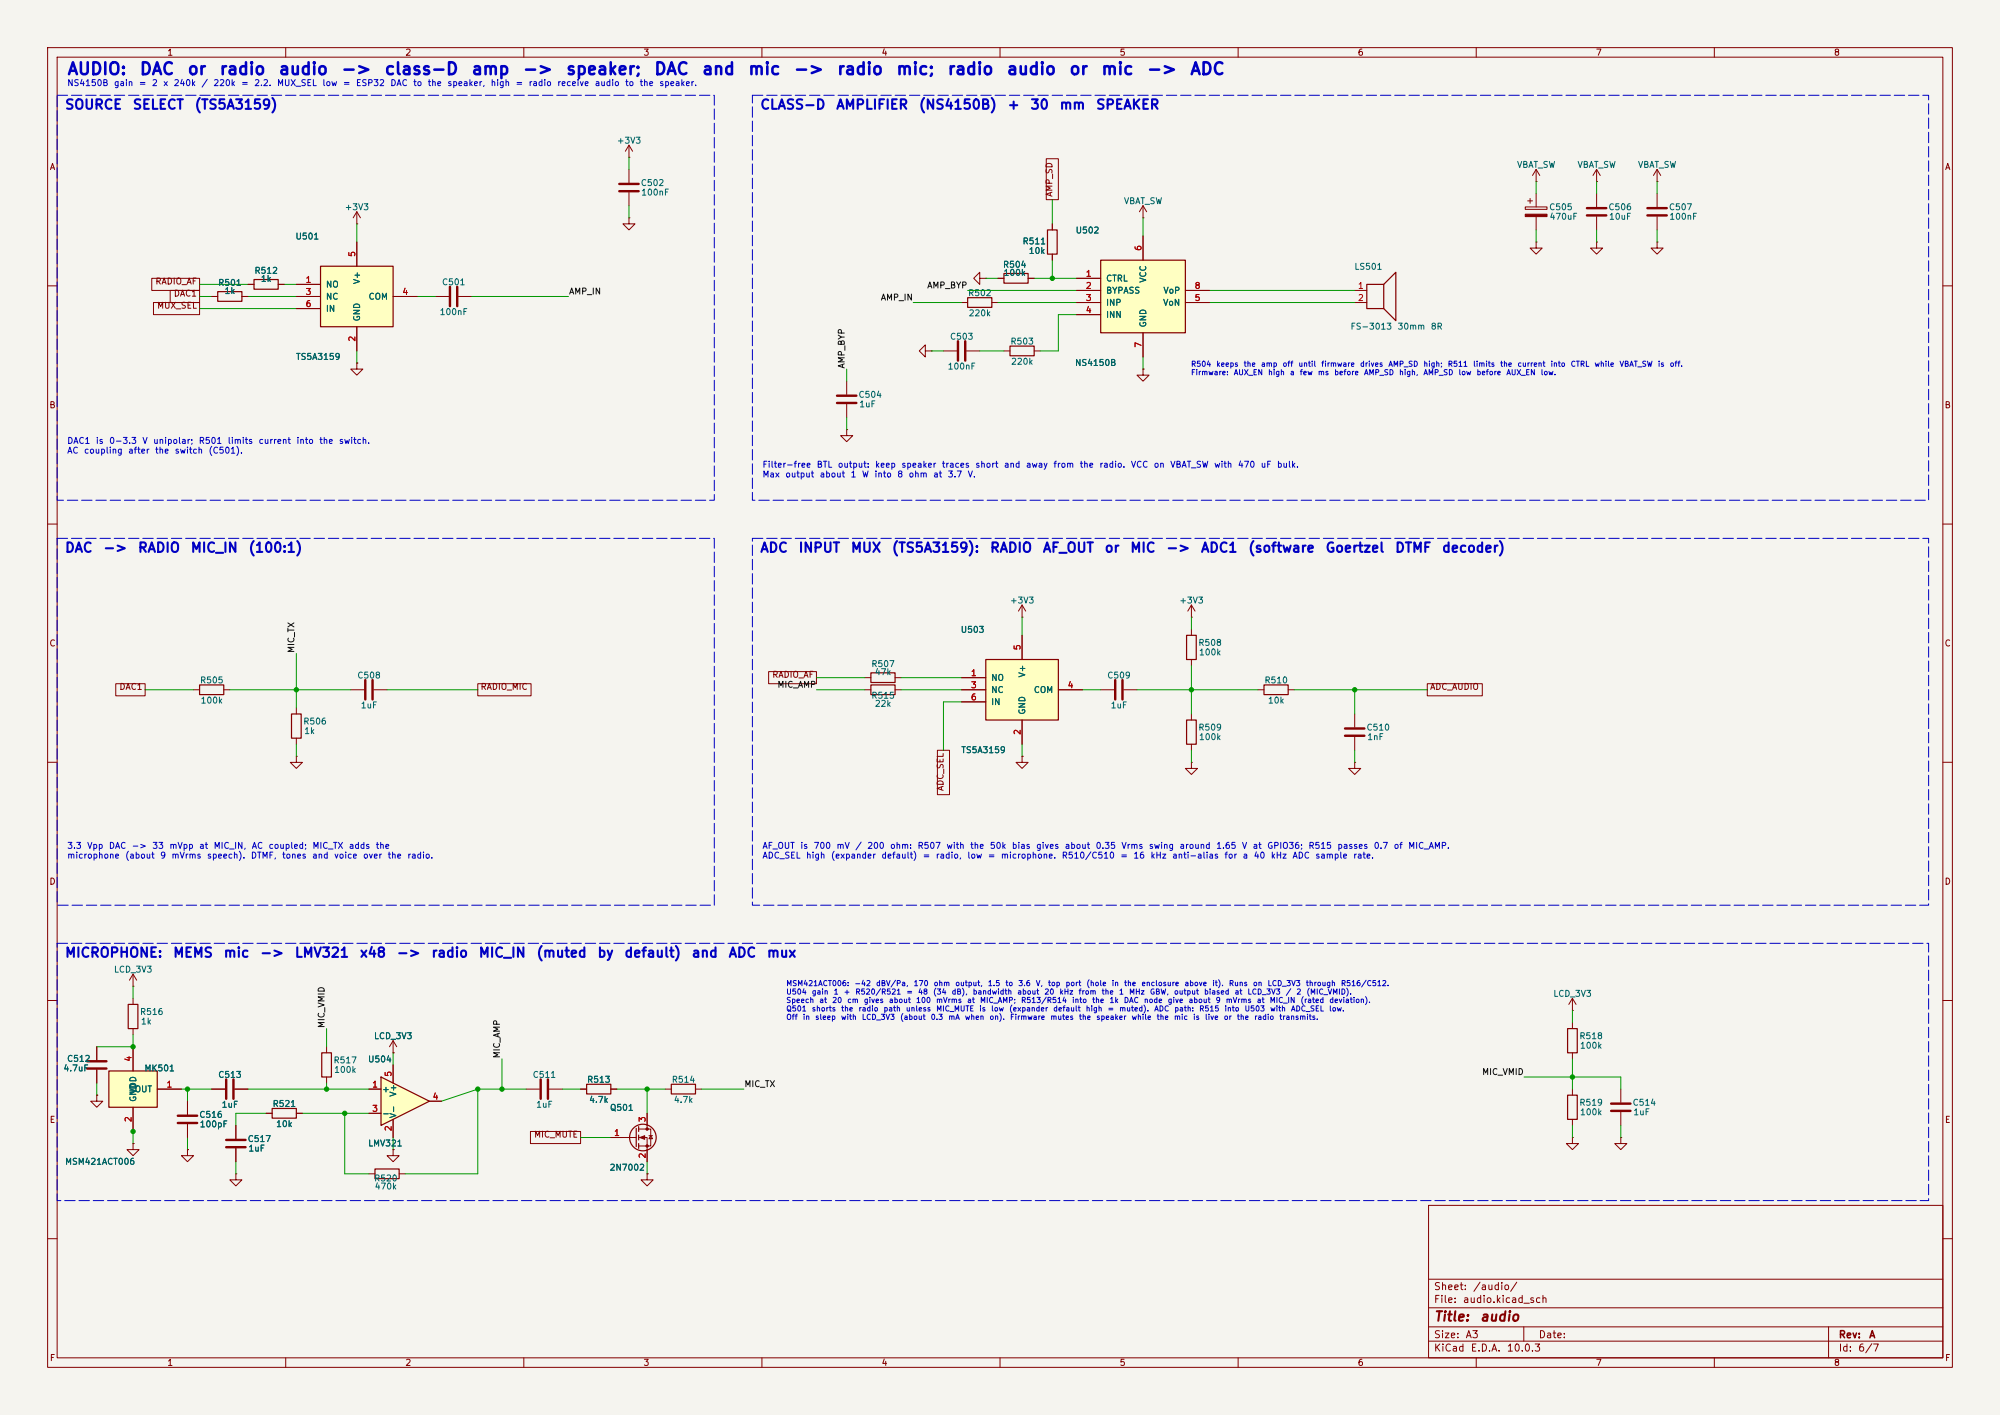
[picture p6: page 6]

AUDIO: DAC or radio audio -> class-D amp -> speaker; DAC and mic -> radio mic; radio audio or mic -> ADC

AF_OUT is 700 mV / 200 ohm: R507 with the 50k bias gives about 0.35 Vrms swing around 1.65 V at GPIO36; R515 passes 0.7 of MIC_AMP. ADC_SEL high (expander default) = radio, low = microphone. R510/C510 = 16 kHz anti-alias for a 40 kHz ADC sample rate. DAC -> RADIO MIC_IN (100:1)

MICROPHONE: MEMS mic -> LMV321 x48 -> radio MIC_IN (muted by default) and ADC mux

MSM421ACT006: -42 dBV/Pa, 170 ohm output, 1.5 to 3.6 V, top port (hole in the enclosure above it). Runs on LCD_3V3 through R516/C512. U504 gain 1 + R520/R521 = 48 (34 dB), bandwidth about 20 kHz from the 1 MHz GBW, output biased at LCD_3V3 / 2 (MIC_VMID).

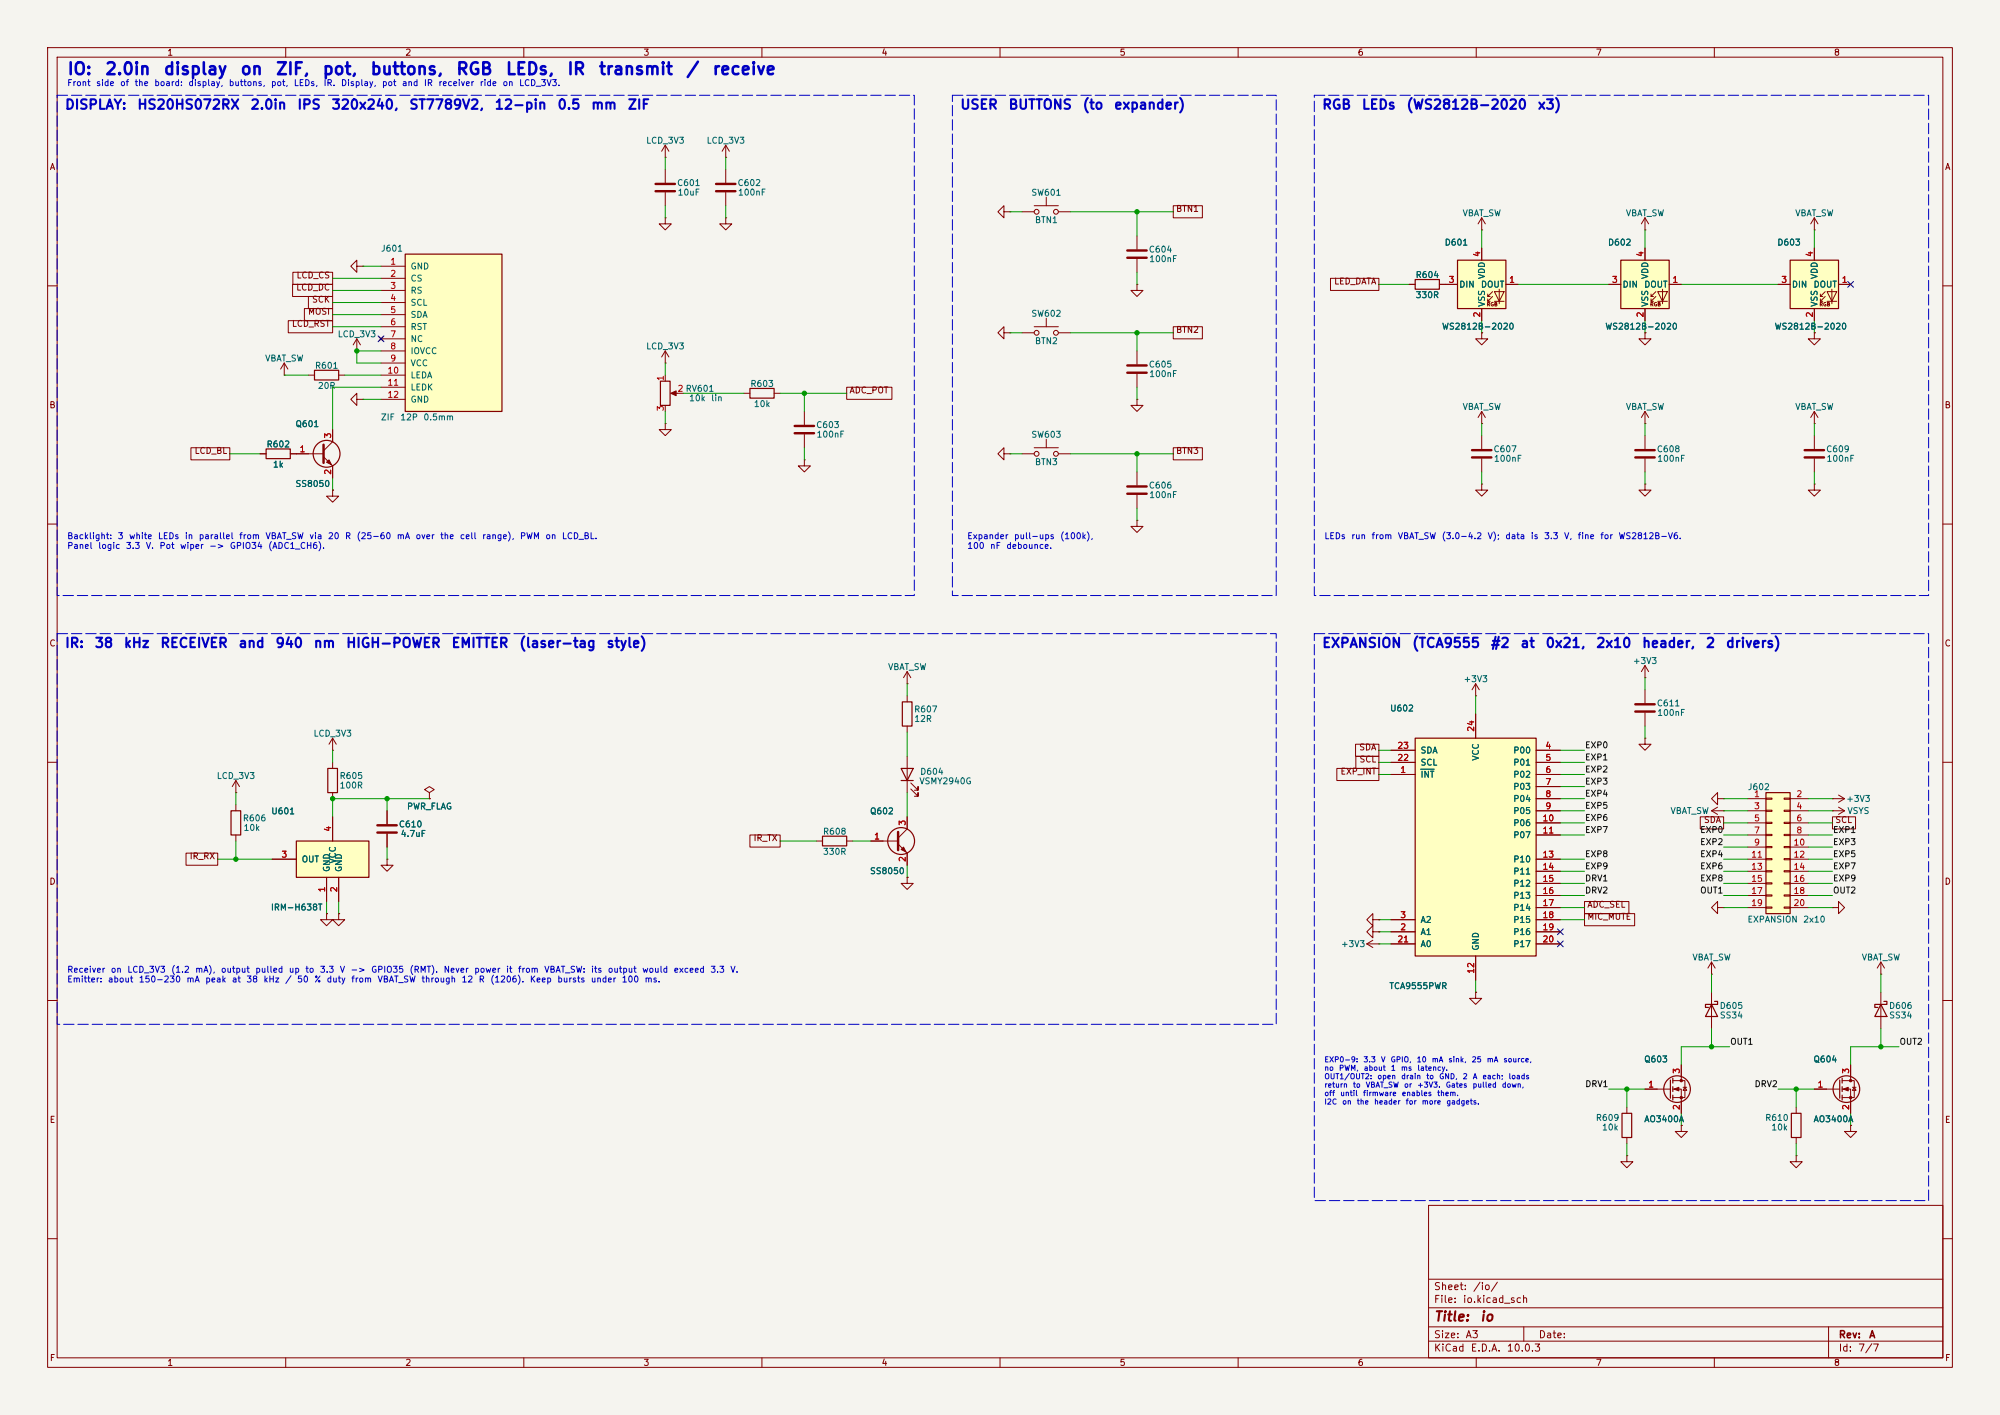
[picture p7: page 7]

IO: 2.0in display on ZIF, pot, buttons, RGB LEDs, IR transmit / receive
DISPLAY: HS20HS072RX 2.0in IPS 320x240, ST7789V2, 12-pin 0.5 mm ZIF

USER BUTTONS (to expander)

IR: 38 kHz RECEIVER and 940 nm HIGH-POWER EMITTER (laser-tag style)

Receiver on LCD_3V3 (1.2 mA), output pulled up to 3.3 V -> GPIO35 (RMT). Never power it from VBAT_SW: its output would exceed 3.3 V. Emitter: about 150-230 mA peak at 38 kHz / 50 % duty from VBAT_SW through 12 R (1206). Keep bursts under 100 ms.

EXP0-9: 3.3 V GPIO, 10 mA sink, 25 mA source, no PWM, about 1 ms latency. OUT1/OUT2: open drain to GND, 2 A each; loads

return to VBAT_SW or +3V3. Gates pulled down, off until firmware enables them.

I2C on the header for more gadgets.
