7kasper/LazerGamebox/hardware/LazerGamebox.kicad_sch

## KiCad design hardware/LazerGamebox.kicad_sch (2026-09-29)

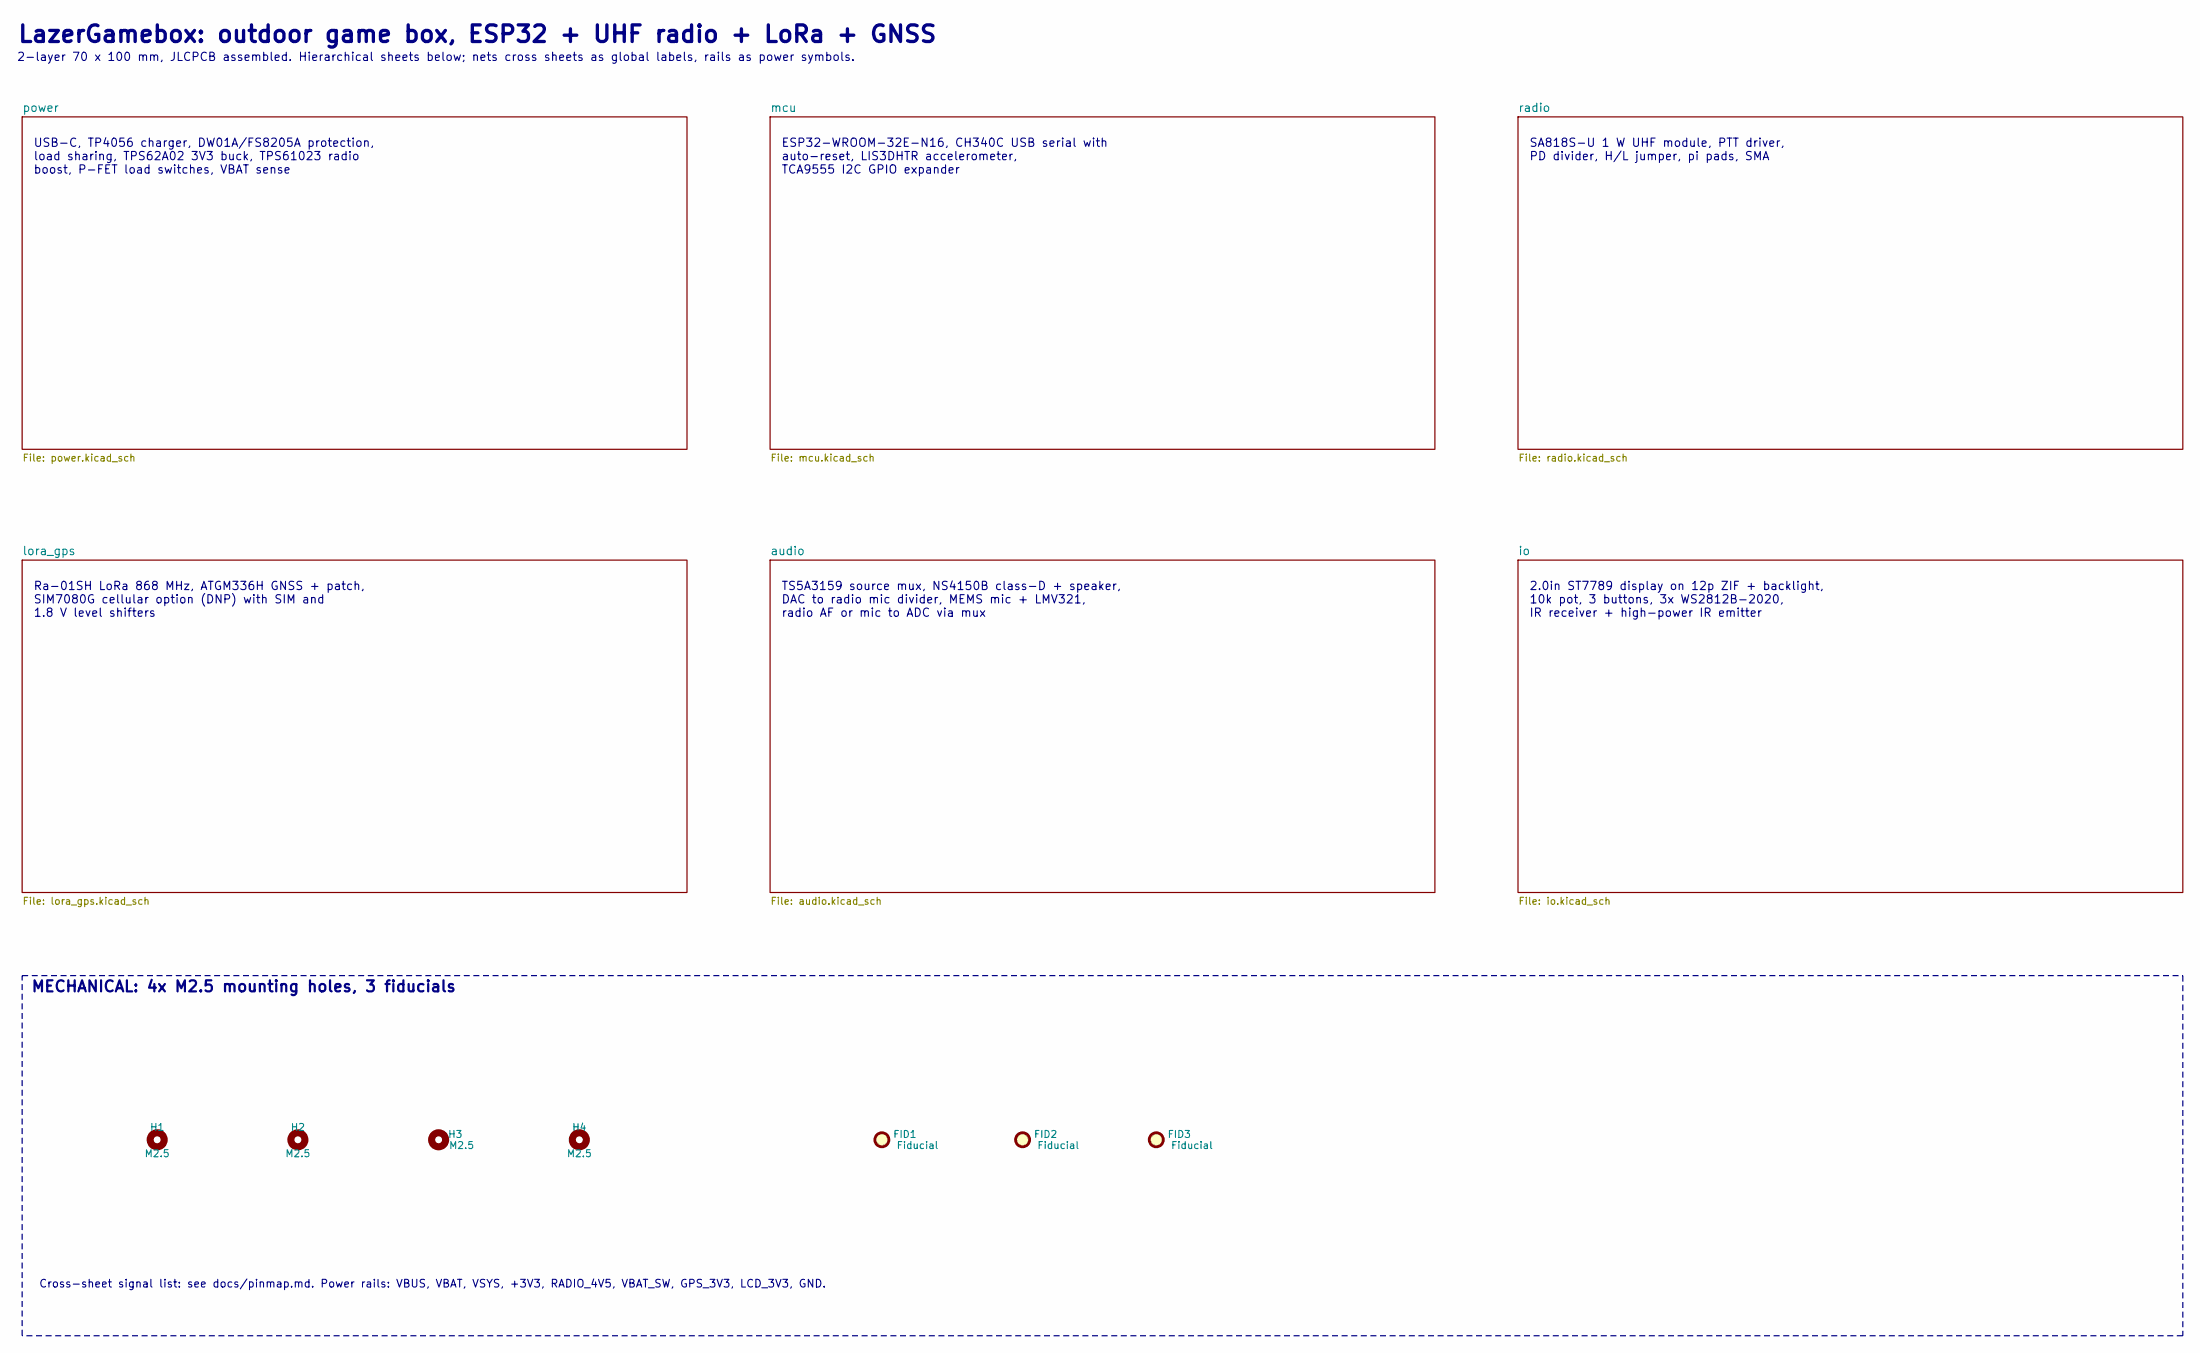
[picture p8: schematic LazerGamebox.kicad_sch]

Parts:
FID1, FID2, FID3: Fiducial; Fiducial_1mm_Mask2mm
H1, H2, H3, H4: M2.5; MountingHole_2.7mm_M2.5

Notes on the sheet:
LazerGamebox: outdoor game box, ESP32 + UHF radio + LoRa + GNSS
2-layer 70 x 100 mm, JLCPCB assembled. Hierarchical sheets below; nets cross sheets as global labels, rails as power symbols.
USB-C, TP4056 charger, DW01A/FS8205A protection, load sharing, TPS62A02 3V3 buck, TPS61023 radio boost, P-FET load switches, VBAT sense
ESP32-WROOM-32E-N16, CH340C USB serial with auto-reset, LIS3DHTR accelerometer, TCA9555 I2C GPIO expander
SA818S-U 1 W UHF module, PTT driver, PD divider, H/L jumper, pi pads, SMA
Ra-01SH LoRa 868 MHz, ATGM336H GNSS + patch, SIM7080G cellular option (DNP) with SIM and 1.8 V level shifters
TS5A3159 source mux, NS4150B class-D + speaker, DAC to radio mic divider, MEMS mic + LMV321, radio AF or mic to ADC via mux
2.0in ST7789 display on 12p ZIF + backlight, 10k pot, 3 buttons, 3x WS2812B-2020, IR receiver + high-power IR emitter
MECHANICAL: 4x M2.5 mounting holes, 3 fiducials
Cross-sheet signal list: see docs/pinmap.md. Power rails: VBUS, VBAT, VSYS, +3V3, RADIO_4V5, VBAT_SW, GPS_3V3, LCD_3V3, GND.
