7kasper/LazerGamebox/hardware/audio.kicad_sch

## KiCad design hardware/audio.kicad_sch (2026-09-29)

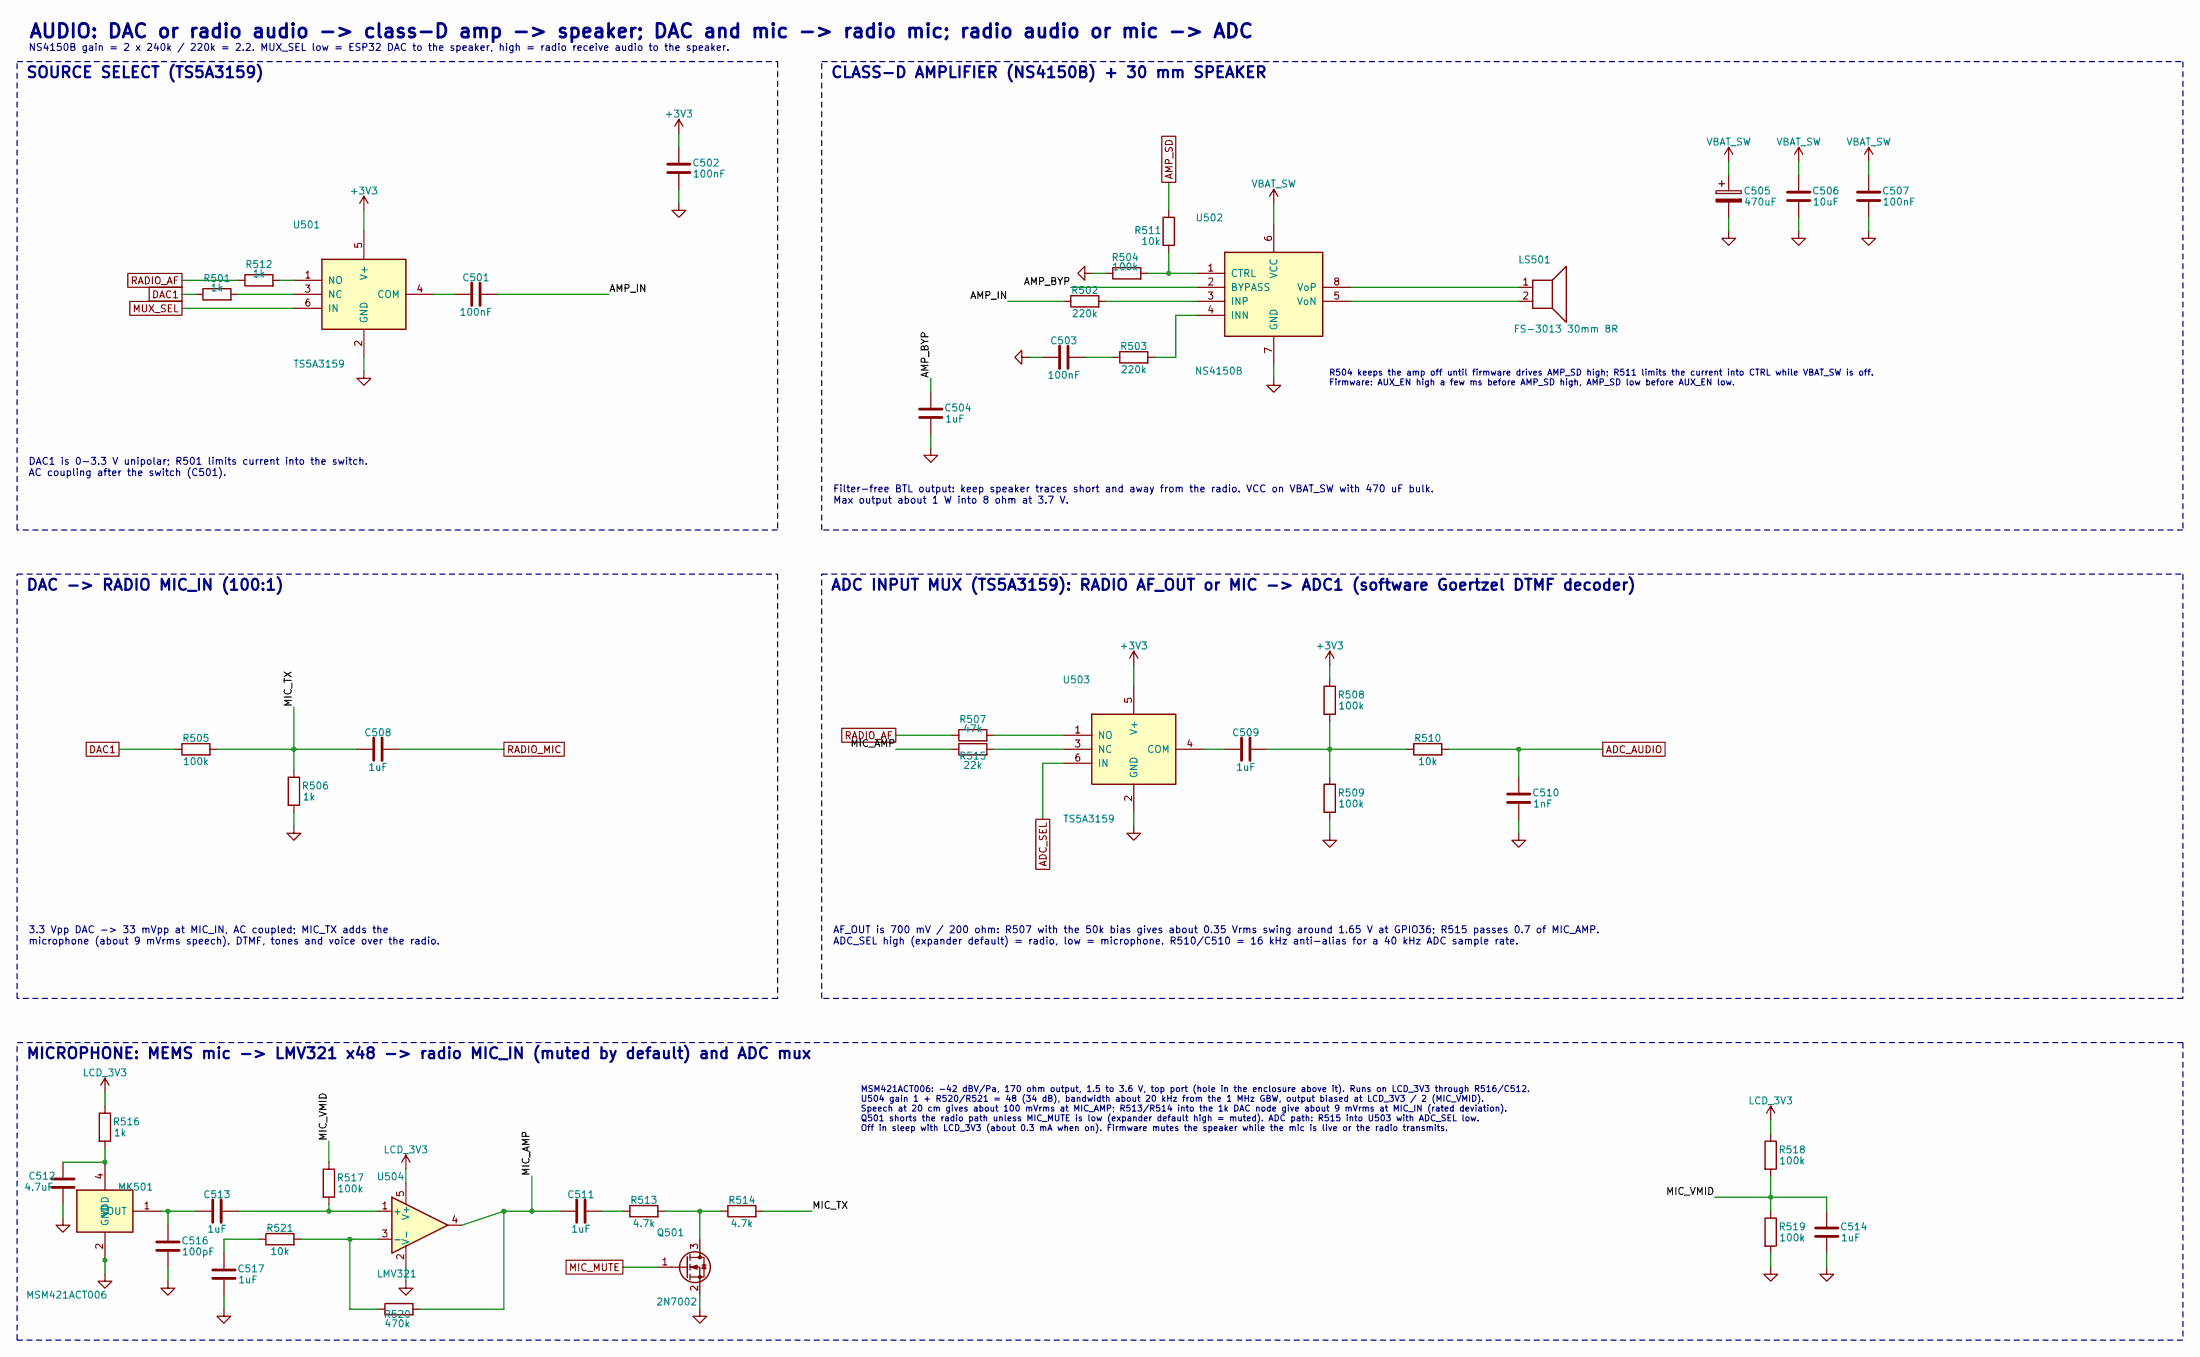
[picture p9: schematic audio.kicad_sch]

Parts:
C501, C502, C503, C507: 100nF; C_0603_1608Metric; LCSC C14663
C504, C508, C509, C511, C513, C514, C517: 1uF; C_0603_1608Metric; LCSC C15849
C505: 470uF; CP_Elec_6.3x7.7; LCSC C2858856
C506: 10uF; C_0805_2012Metric; LCSC C15850
C510: 1nF; C_0603_1608Metric; LCSC C1588
C512: 4.7uF; C_0603_1608Metric; LCSC C19666
C516: 100pF; C_0603_1608Metric; LCSC C14858
LS501: FS-3013 30mm 8R; BEEP-TH_BD30.0-P15.00-D1.0; LCSC C482323
MK501: MSM421ACT006; MIC-SMD_4P-L2.8-W1.9-P1.01-TL; LCSC C51928207
Q501: 2N7002; SOT-23; LCSC C8545
R501, R506, R512, R516: 1k; R_0603_1608Metric; LCSC C21190
R502, R503: 220k; R_0603_1608Metric; LCSC C22961
R504, R505, R508, R509, R517, R518, R519: 100k; R_0603_1608Metric; LCSC C25803
R507: 47k; R_0603_1608Metric; LCSC C25819
R510, R511, R521: 10k; R_0603_1608Metric; LCSC C25804
R513, R514: 4.7k; R_0603_1608Metric; LCSC C23162
R515: 22k; R_0603_1608Metric; LCSC C31850
R520: 470k; R_0603_1608Metric; LCSC C23164
U501, U503: TS5A3159; SOT-363_SC-70-6; LCSC C46388
U502: NS4150B; MSOP-8_3x3mm_P0.65mm; LCSC C189961
U504: LMV321; SOT-23-5; LCSC C7972

Connections:
+3V3: C502.1, R508.1, U501.5 (V+), U503.5 (V+)
ADC_AUDIO: C510.1, R510.2
ADC_SEL: U503.6 (IN)
AMP_BYP: C504.1, U502.2 (BYPASS)
AMP_IN: C501.2, R502.1
AMP_SD: R511.1
DAC1: R501.1, R505.1
GND: C502.2, C503.1, C504.2, C505.2, C506.2, C507.2, C510.2, C512.2, C514.2, C516.2, C517.2, MK501.2 (GND), MK501.3 (GND), Q501.2 (S), R504.1, R506.2, R509.2, R519.2, U501.2 (GND), U502.7 (GND), U503.2 (GND), U504.2 (V-)
LCD_3V3: R516.1, R518.1, U504.5 (V+)
MIC_AMP: C511.1, R515.1, R520.2, U504.4
MIC_MUTE: Q501.1 (G)
MIC_TX: C508.1, R505.2, R506.1, R514.2
MIC_VMID: C514.1, R517.1, R518.2, R519.1
MUX_SEL: U501.6 (IN)
unnamed: C501.1, U501.4 (COM)
unnamed: C503.2, R503.1
unnamed: C509.1, U503.4 (COM)
unnamed: C509.2, R508.2, R509.1, R510.1
unnamed: C511.2, R513.1
unnamed: C512.1, MK501.4 (VDD), R516.2
unnamed: C513.1, C516.1, MK501.1 (OUT)
unnamed: C513.2, R517.2, U504.1 (+)
unnamed: C517.1, R521.1
unnamed: LS501.1, U502.8 (VoP)
unnamed: LS501.2, U502.5 (VoN)
unnamed: Q501.3 (D), R513.2, R514.1
unnamed: R501.2, U501.3 (NC)
unnamed: R502.2, U502.3 (INP)
unnamed: R503.2, U502.4 (INN)
unnamed: R504.2, R511.2, U502.1 (CTRL)
unnamed: R507.2, U503.1 (NO)
unnamed: R512.2, U501.1 (NO)
unnamed: R515.2, U503.3 (NC)
unnamed: R520.1, R521.2, U504.3 (-)
RADIO_AF: R507.1, R512.1
RADIO_MIC: C508.2
VBAT_SW: C505.1, C506.1, C507.1, U502.6 (VCC)

Notes on the sheet:
AUDIO: DAC or radio audio -> class-D amp -> speaker; DAC and mic -> radio mic; radio audio or mic -> ADC
NS4150B gain = 2 x 240k / 220k = 2.2. MUX_SEL low = ESP32 DAC to the speaker, high = radio receive audio to the speaker.
SOURCE SELECT (TS5A3159)
DAC1 is 0-3.3 V unipolar; R501 limits current into the switch. AC coupling after the switch (C501).
CLASS-D AMPLIFIER (NS4150B) + 30 mm SPEAKER
R504 keeps the amp off until firmware drives AMP_SD high; R511 limits the current into CTRL while VBAT_SW is off. Firmware: AUX_EN high a few ms before AMP_SD high, AMP_SD low before AUX_EN low.
Filter-free BTL output: keep speaker traces short and away from the radio. VCC on VBAT_SW with 470 uF bulk. Max output about 1 W into 8 ohm at 3.7 V.
DAC -> RADIO MIC_IN (100:1)
3.3 Vpp DAC -> 33 mVpp at MIC_IN, AC coupled; MIC_TX adds the microphone (about 9 mVrms speech). DTMF, tones and voice over the radio.
ADC INPUT MUX (TS5A3159): RADIO AF_OUT or MIC -> ADC1 (software Goertzel DTMF decoder)
AF_OUT is 700 mV / 200 ohm: R507 with the 50k bias gives about 0.35 Vrms swing around 1.65 V at GPIO36; R515 passes 0.7 of MIC_AMP. ADC_SEL high (expander default) = radio, low = microphone. R510/C510 = 16 kHz anti-alias for a 40 kHz ADC sample rate.
MICROPHONE: MEMS mic -> LMV321 x48 -> radio MIC_IN (muted by default) and ADC mux
MSM421ACT006: -42 dBV/Pa, 170 ohm output, 1.5 to 3.6 V, top port (hole in the enclosure above it). Runs on LCD_3V3 through R516/C512. U504 gain 1 + R520/R521 = 48 (34 dB), bandwidth about 20 kHz from the 1 MHz GBW, output biased at LCD_3V3 / 2 (MIC_VMID). Speech at 20 cm gives about 100 mVrms at MI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
