7kasper/LazerGamebox/hardware/io.kicad_sch

## KiCad design hardware/io.kicad_sch (2026-09-29)

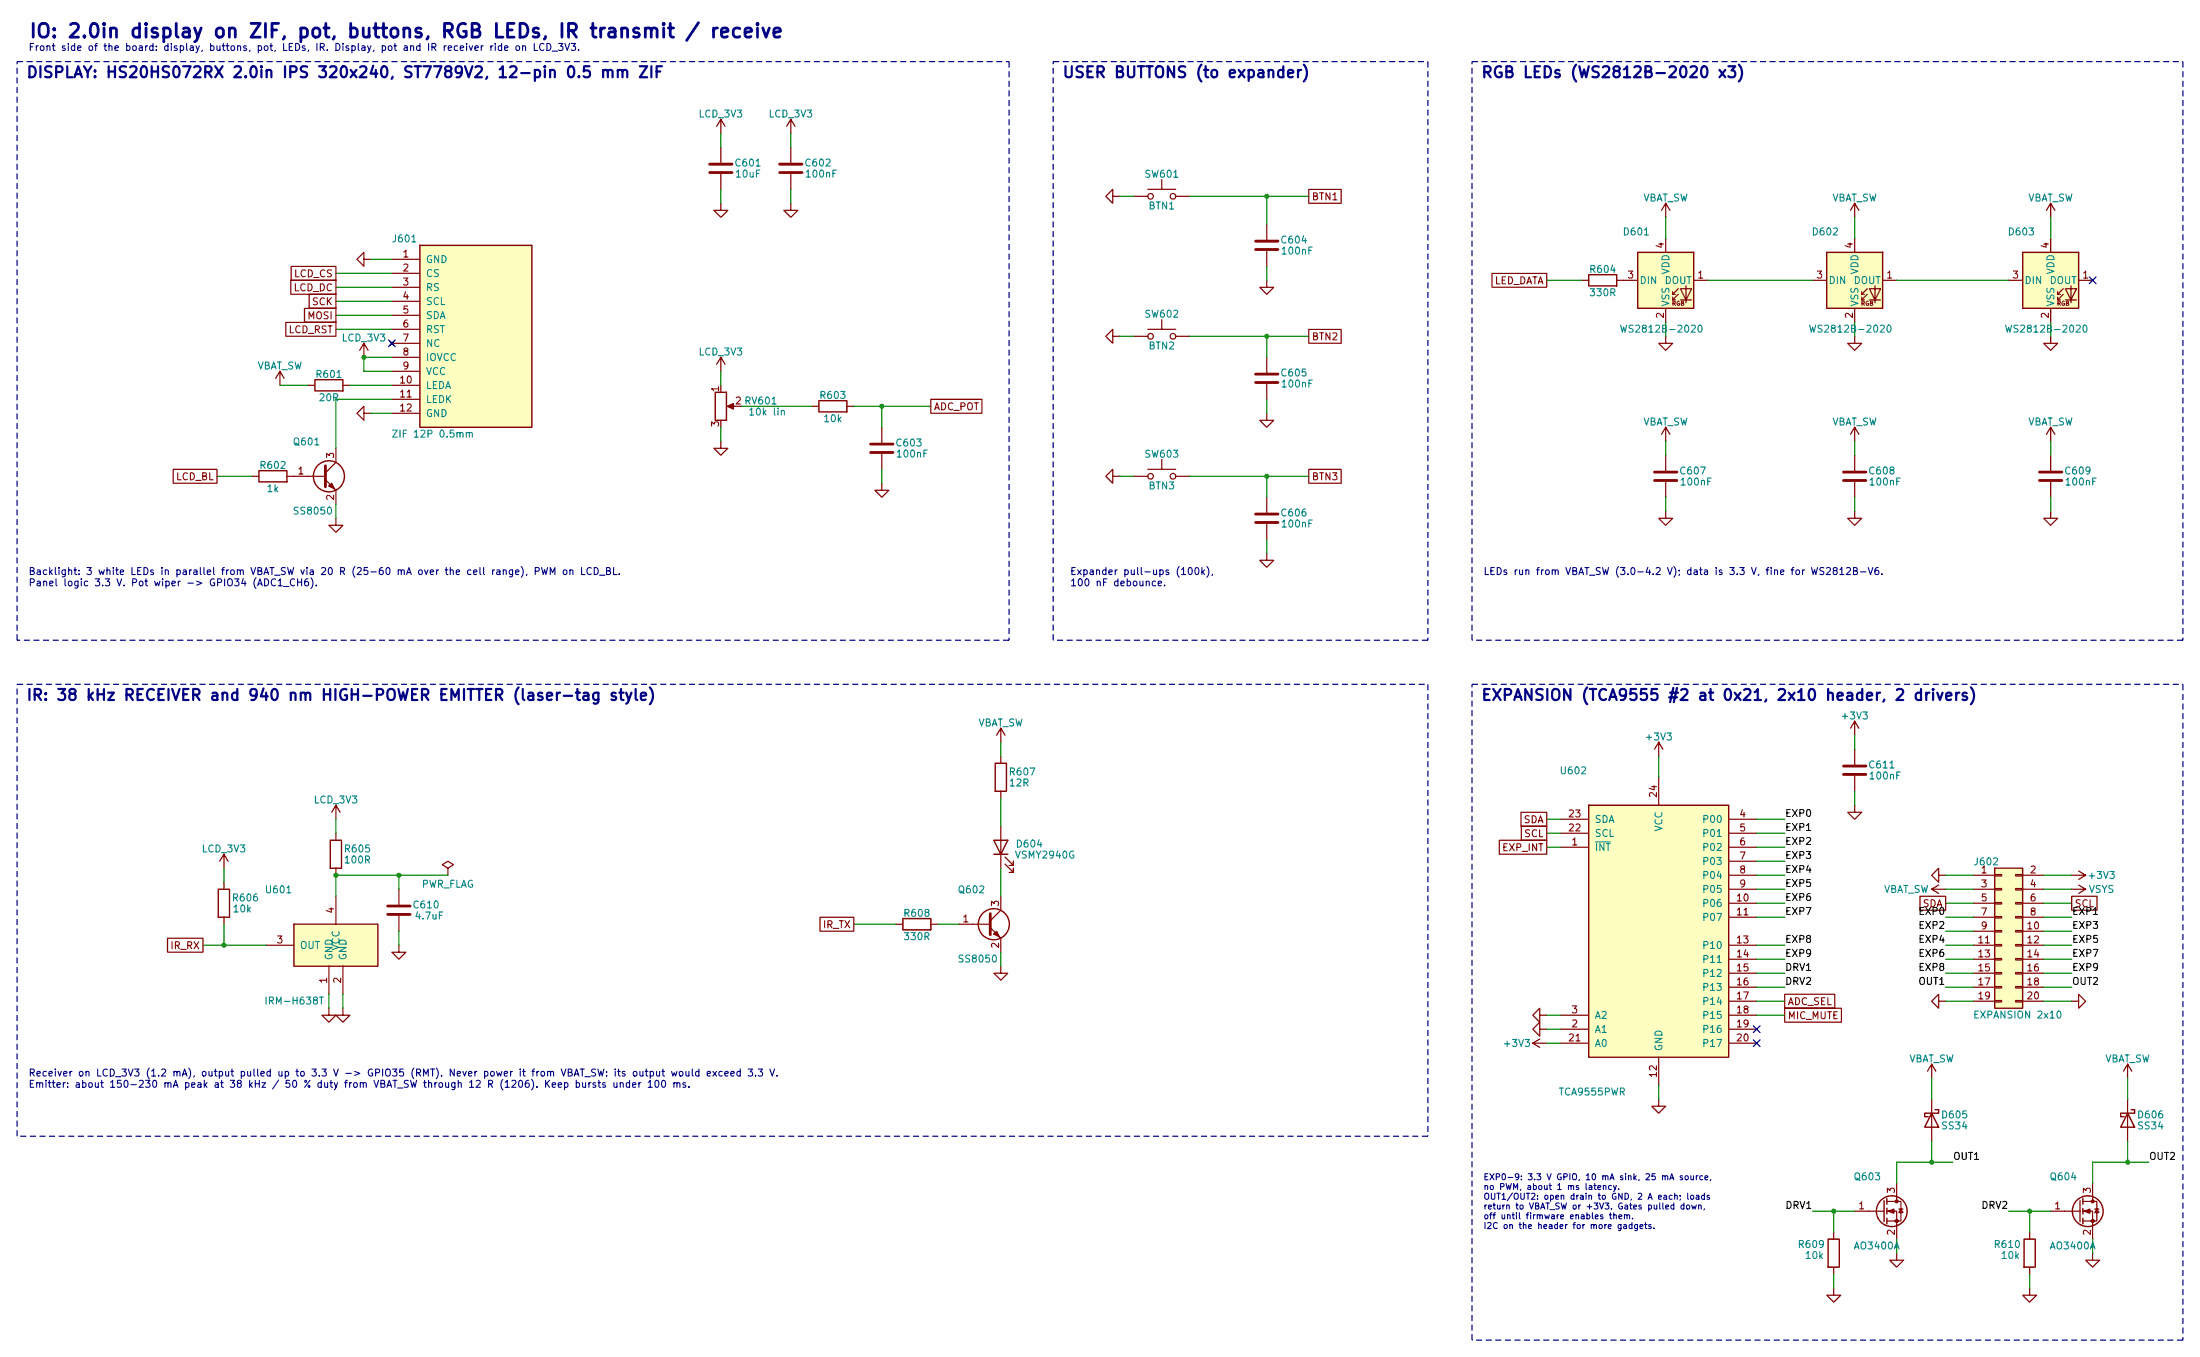
[picture p10: schematic io.kicad_sch]

Parts:
C601: 10uF; C_0805_2012Metric; LCSC C15850
C602, C603, C604, C605, C606, C607, C608, C609, C611: 100nF; C_0603_1608Metric; LCSC C14663
C610: 4.7uF; C_0603_1608Metric; LCSC C19666
D601, D602, D603: WS2812B-2020; LED_WS2812B-2020_PLCC4_2.0x2.0mm; LCSC C52917434
D604: VSMY2940G; LED-SMD_L2.3-W2.3-RD_VSMY2940G; LCSC C499547
D605, D606: SS34; D_SMA; LCSC C8678
J601: ZIF 12P 0.5mm; FPC-SMD_12P-P0.50_05A20H12P; LCSC C5362174
J602: EXPANSION 2x10; PinHeader_2x10_P2.54mm_Vertical; LCSC C5383109
Q601, Q602: SS8050; SOT-23; LCSC C2150
Q603, Q604: AO3400A; SOT-23; LCSC C20917
R601: 20R; R_0805_2012Metric; LCSC C17544
R602: 1k; R_0603_1608Metric; LCSC C21190
R603, R606, R609, R610: 10k; R_0603_1608Metric; LCSC C25804
R604, R608: 330R; R_0603_1608Metric; LCSC C23138
R605: 100R; R_0603_1608Metric; LCSC C22775
R607: 12R; R_1206_3216Metric; LCSC C17913
RV601: 10k lin; Potentiometer_Alps_RK09K1130A6S_LCSC; LCSC C209770
SW601: BTN1; SW_Push_1P1T_XKB_TS-1187A; LCSC C318884
SW602: BTN2; SW_Push_1P1T_XKB_TS-1187A; LCSC C318884
SW603: BTN3; SW_Push_1P1T_XKB_TS-1187A; LCSC C318884
U601: IRM-H638T; Everlight_IRM-H6xxT; LCSC C91447
U602: TCA9555PWR; TSSOP-24_4.4x7.8mm_P0.65mm; LCSC C465732

Connections:
+3V3: C611.1, J602.2, U602.21 (A0), U602.24 (VCC)
ADC_POT: C603.1, R603.2
ADC_SEL: U602.17 (P14)
BTN1: C604.1, SW601.2
BTN2: C605.1, SW602.2
BTN3: C606.1, SW603.2
DRV1: Q603.1 (G), R609.1, U602.15 (P12)
DRV2: Q604.1 (G), R610.1, U602.16 (P13)
EXP0: J602.7, U602.4 (P00)
EXP1: J602.8, U602.5 (P01)
EXP2: J602.9, U602.6 (P02)
EXP3: J602.10, U602.7 (P03)
EXP4: J602.11, U602.8 (P04)
EXP5: J602.12, U602.9 (P05)
EXP6: J602.13, U602.10 (P06)
EXP7: J602.14, U602.11 (P07)
EXP8: J602.15, U602.13 (P10)
EXP9: J602.16, U602.14 (P11)
EXP_INT: U602.1 (~INT)
GND: C601.2, C602.2, C603.2, C604.2, C605.2, C606.2, C607.2, C608.2, C609.2, C610.2, C611.2, D601.2 (VSS), D602.2 (VSS), D603.2 (VSS), J601.1 (GND), J601.12 (GND), J602.1, J602.19, J602.20, Q601.2 (E), Q602.2 (E), Q603.2 (S), Q604.2 (S), R609.2, R610.2, RV601.3, SW601.1, SW602.1, SW603.1, U601.1 (GND), U601.2 (GND), U602.2 (A1), U602.3 (A2), U602.12 (GND)
IR_RX: R606.2, U601.3 (OUT)
IR_TX: R608.1
LCD_3V3: C601.1, C602.1, J601.8 (IOVCC), J601.9 (VCC), R605.1, R606.1, RV601.1
LCD_BL: R602.1
LCD_CS: J601.2 (CS)
LCD_DC: J601.3 (RS)
LCD_RST: J601.6 (RST)
LED_DATA: R604.1
MIC_MUTE: U602.18 (P15)
MOSI: J601.5 (SDA)
unnamed: C610.1, R605.2, U601.4 (VCC)
unnamed: D601.1 (DOUT), D602.3 (DIN)
unnamed: D601.3 (DIN), R604.2
unnamed: D602.1 (DOUT), D603.3 (DIN)
unnamed: D604.1 (K), Q602.3 (C)
unnamed: D604.2 (A), R607.2
unnamed: J601.10 (LEDA), R601.2
unnamed: J601.11 (LEDK), Q601.3 (C)
unnamed: Q601.1 (B), R602.2
unnamed: Q602.1 (B), R608.2
unnamed: R603.1, RV601.2
OUT1: D605.2 (A), J602.17, Q603.3 (D)
OUT2: D606.2 (A), J602.18, Q604.3 (D)
SCK: J601.4 (SCL)
SCL: J602.6, U602.22 (SCL)
SDA: J602.5, U602.23 (SDA)
VBAT_SW: C607.1, C608.1, C609.1, D601.4 (VDD), D602.4 (VDD), D603.4 (VDD), D605.1 (K), D606.1 (K), J602.3, R601.1, R607.1
VSYS: J602.4

Notes on the sheet:
IO: 2.0in display on ZIF, pot, buttons, RGB LEDs, IR transmit / receive
Front side of the board: display, buttons, pot, LEDs, IR. Display, pot and IR receiver ride on LCD_3V3.
DISPLAY: HS20HS072RX 2.0in IPS 320x240, ST7789V2, 12-pin 0.5 mm ZIF
Backlight: 3 white LEDs in parallel from VBAT_SW via 20 R (25-60 mA over the cell range), PWM on LCD_BL. Panel logic 3.3 V. Pot wiper -> GPIO34 (ADC1_CH6).
USER BUTTONS (to expander)
Expander pull-ups (100k), 100 nF debounce.
RGB LEDs (WS2812B-2020 x3)
LEDs run from VBAT_SW (3.0-4.2 V); data is 3.3 V, fine for WS2812B-V6.
EXPANSION (TCA9555 #2 at 0x21, 2x10 header, 2 drivers)
EXP0-9: 3.3 V GPIO, 10 mA sink, 25 mA source, no PWM, about 1 ms latency. OUT1/OUT2: open drain to GND, 2 A each; loads return to VBAT_SW or +3V3. Gates pulled down, off until firmware enables them. I2C on the header for more gadgets.
IR: 38 kHz RECEIVER and 940 nm HIGH-POWER EMITTER (laser-tag style)
Receiver on LCD_3V3 (1.2 mA), output pulled up to 3.3 V -> GPIO35 (RMT). Never power it from VBAT_SW: its output would exceed 3.3 V. Emitter: about 150-230 mA peak at 38 kHz / 50 % duty from VBAT_SW through 12 R (1206). Keep bursts under 100 ms.
