7kasper/LazerGamebox/hardware/lora_gps.kicad_sch

## KiCad design hardware/lora_gps.kicad_sch (2026-09-29)

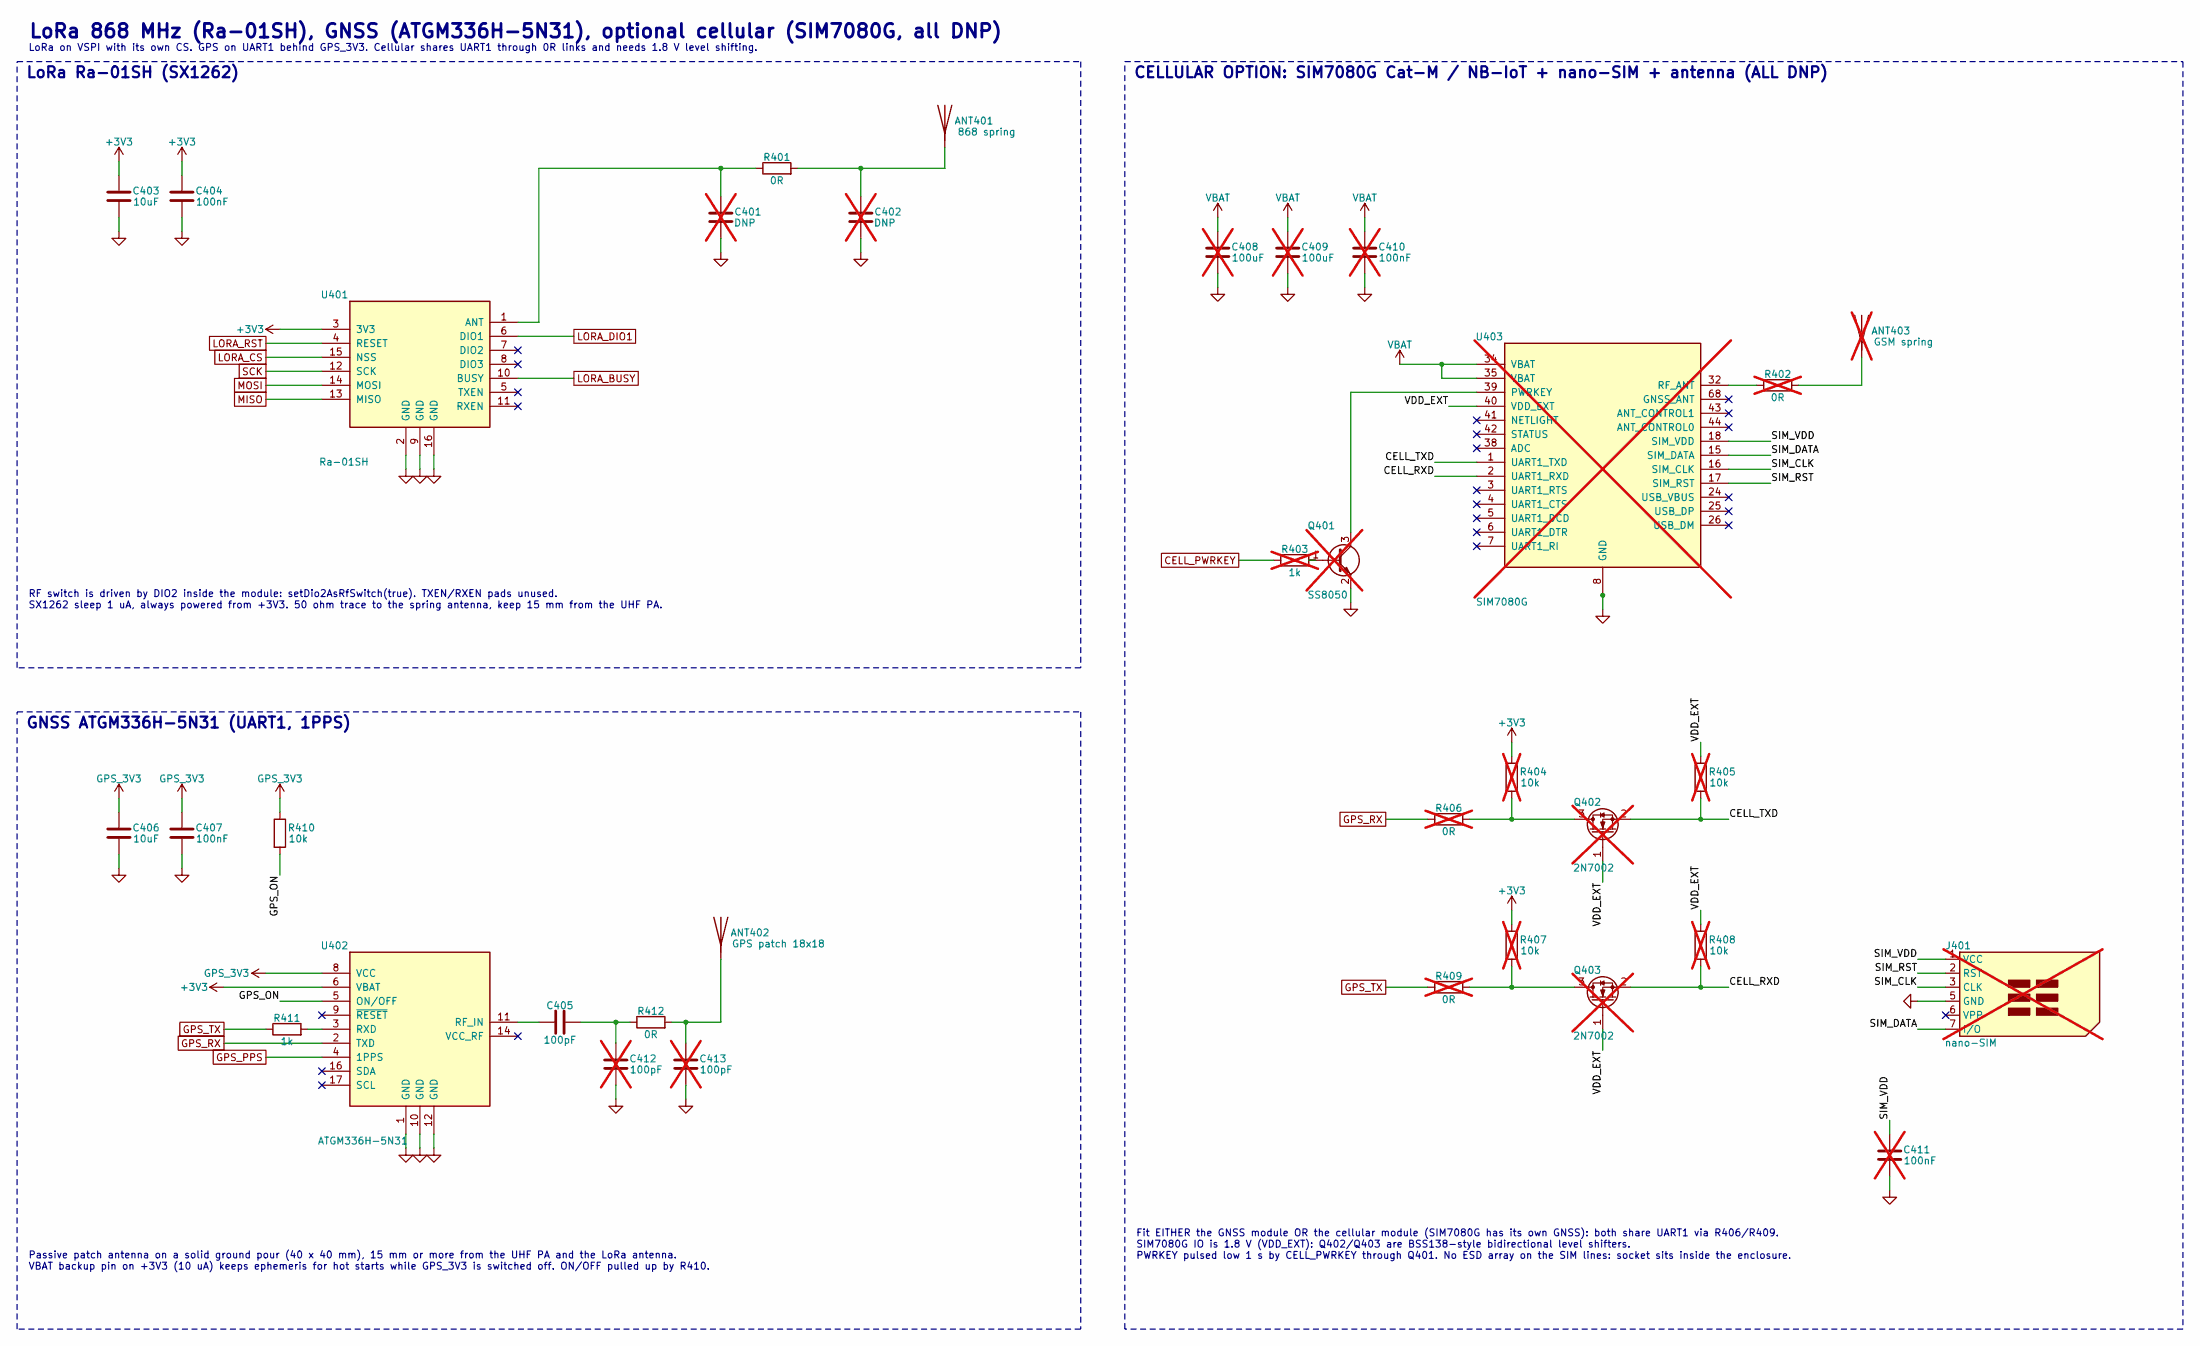
[picture p11: schematic lora_gps.kicad_sch]

Parts:
ANT401: 868 spring; ANT-TH_BW868SNX20-5Z6; LCSC C496555
ANT402: GPS patch 18x18; ANT-TH_L18.0-W18.0_C9900026472; LCSC C784395
ANT403: GSM spring; ANT-TH_1P; LCSC C381192; not fitted
C401, C402: DNP; C_0603_1608Metric; not fitted
C403, C406: 10uF; C_0805_2012Metric; LCSC C15850
C404, C407: 100nF; C_0603_1608Metric; LCSC C14663
C405: 100pF; C_0603_1608Metric; LCSC C14858
C408, C409: 100uF; C_1206_3216Metric; LCSC C15008; not fitted
C410, C411: 100nF; C_0603_1608Metric; LCSC C14663; not fitted
C412, C413: 100pF; C_0603_1608Metric; LCSC C14858; not fitted
J401: nano-SIM; SIM-SMD_NANO-SIM-XG6P-H1.35; LCSC C7529386; not fitted
Q401: SS8050; SOT-23; LCSC C2150; not fitted
Q402, Q403: 2N7002; SOT-23; LCSC C8545; not fitted
R401, R412: 0R; R_0603_1608Metric; LCSC C21189
R402, R406, R409: 0R; R_0603_1608Metric; LCSC C21189; not fitted
R403: 1k; R_0603_1608Metric; LCSC C21190; not fitted
R404, R405, R407, R408: 10k; R_0603_1608Metric; LCSC C25804; not fitted
R410: 10k; R_0603_1608Metric; LCSC C25804
R411: 1k; R_0603_1608Metric; LCSC C21190
U401: Ra-01SH; WIRELM-SMD_RA-01SH; LCSC C2764087
U402: ATGM336H-5N31; GPSM-SMD_ATGM336H-TR; LCSC C90770
U403: SIM7080G; LCC-SMD_SIM7080G; LCSC C2943992; not fitted

Connections:
+3V3: C403.1, C404.1, R404.1, R407.1, U401.3 (3V3), U402.6 (VBAT)
CELL_PWRKEY: R403.1
CELL_RXD: Q403.2 (S), R408.2, U403.2 (UART1_RXD)
CELL_TXD: Q402.2 (S), R405.2, U403.1 (UART1_TXD)
GND: C401.2, C402.2, C403.2, C404.2, C406.2, C407.2, C408.2, C409.2, C410.2, C411.2, C412.2, C413.2, J401.5 (GND), Q401.2 (E), U401.2 (GND), U401.9 (GND), U401.16 (GND), U402.1 (GND), U402.10 (GND), U402.12 (GND), U403.8 (GND), U403.13 (GND), U403.19 (GND), U403.21 (GND), U403.27 (GND), U403.30 (GND), U403.31 (GND), U403.33 (GND), U403.36 (GND), U403.37 (GND), U403.45 (GND), U403.63 (GND), U403.66 (GND), U403.67 (GND), U403.69 (GND), U403.70 (GND), U403.71 (GND), U403.72 (GND), U403.73 (GND), U403.74 (GND), U403.75 (GND), U403.76 (GND), U403.77 (GND)
GPS_3V3: C406.1, C407.1, R410.1, U402.8 (VCC)
GPS_ON: R410.2, U402.5 (ON/OFF)
GPS_PPS: U402.4 (1PPS)
GPS_RX: R406.1, U402.2 (TXD)
GPS_TX: R409.1, R411.1
LORA_BUSY: U401.10 (BUSY)
LORA_CS: U401.15 (NSS)
LORA_DIO1: U401.6 (DIO1)
LORA_RST: U401.4 (RESET)
MISO: U401.13 (MISO)
MOSI: U401.14 (MOSI)
unnamed: ANT401.1, C402.1, R401.2
unnamed: ANT402.1, C413.1, R412.2
unnamed: ANT403.1, R402.2
unnamed: C401.1, R401.1, U401.1 (ANT)
unnamed: C405.1, U402.11 (RF_IN)
unnamed: C405.2, C412.1, R412.1
unnamed: Q401.1 (B), R403.2
unnamed: Q401.3 (C), U403.39 (PWRKEY)
unnamed: Q402.3 (D), R404.2, R406.2
unnamed: Q403.3 (D), R407.2, R409.2
unnamed: R402.1, U403.32 (RF_ANT)
unnamed: R411.2, U402.3 (RXD)
SCK: U401.12 (SCK)
SIM_CLK: J401.3 (CLK), U403.16 (SIM_CLK)
SIM_DATA: J401.7 (I/O), U403.15 (SIM_DATA)
SIM_RST: J401.2 (RST), U403.17 (SIM_RST)
SIM_VDD: C411.1, J401.1 (VCC), U403.18 (SIM_VDD)
VBAT: C408.1, C409.1, C410.1, U403.34 (VBAT), U403.35 (VBAT)
VDD_EXT: Q402.1 (G), Q403.1 (G), R405.1, R408.1, U403.40 (VDD_EXT)

Notes on the sheet:
LoRa 868 MHz (Ra-01SH), GNSS (ATGM336H-5N31), optional cellular (SIM7080G, all DNP)
LoRa on VSPI with its own CS. GPS on UART1 behind GPS_3V3. Cellular shares UART1 through 0R links and needs 1.8 V level shifting.
LoRa Ra-01SH (SX1262)
RF switch is driven by DIO2 inside the module: setDio2AsRfSwitch(true). TXEN/RXEN pads unused. SX1262 sleep 1 uA, always powered from +3V3. 50 ohm trace to the spring antenna, keep 15 mm from the UHF PA.
GNSS ATGM336H-5N31 (UART1, 1PPS)
Passive patch antenna on a solid ground pour (40 x 40 mm), 15 mm or more from the UHF PA and the LoRa antenna. VBAT backup pin on +3V3 (10 uA) keeps ephemeris for hot starts while GPS_3V3 is switched off. ON/OFF pulled up by R410.
CELLULAR OPTION: SIM7080G Cat-M / NB-IoT + nano-SIM + antenna (ALL DNP)
Fit EITHER the GNSS module OR the cellular module (SIM7080G has its own GNSS): both share UART1 via R406/R409. SIM7080G IO is 1.8 V (VDD_EXT): Q402/Q403 are BSS138-style bidirectional level shifters. PWRKEY pulsed low 1 s by CELL_PWRKEY through Q401. No ESD array on the SIM lines: socket sits insid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
