7kasper/LazerGamebox/hardware/mcu.kicad_sch

## KiCad design hardware/mcu.kicad_sch (2026-09-29)

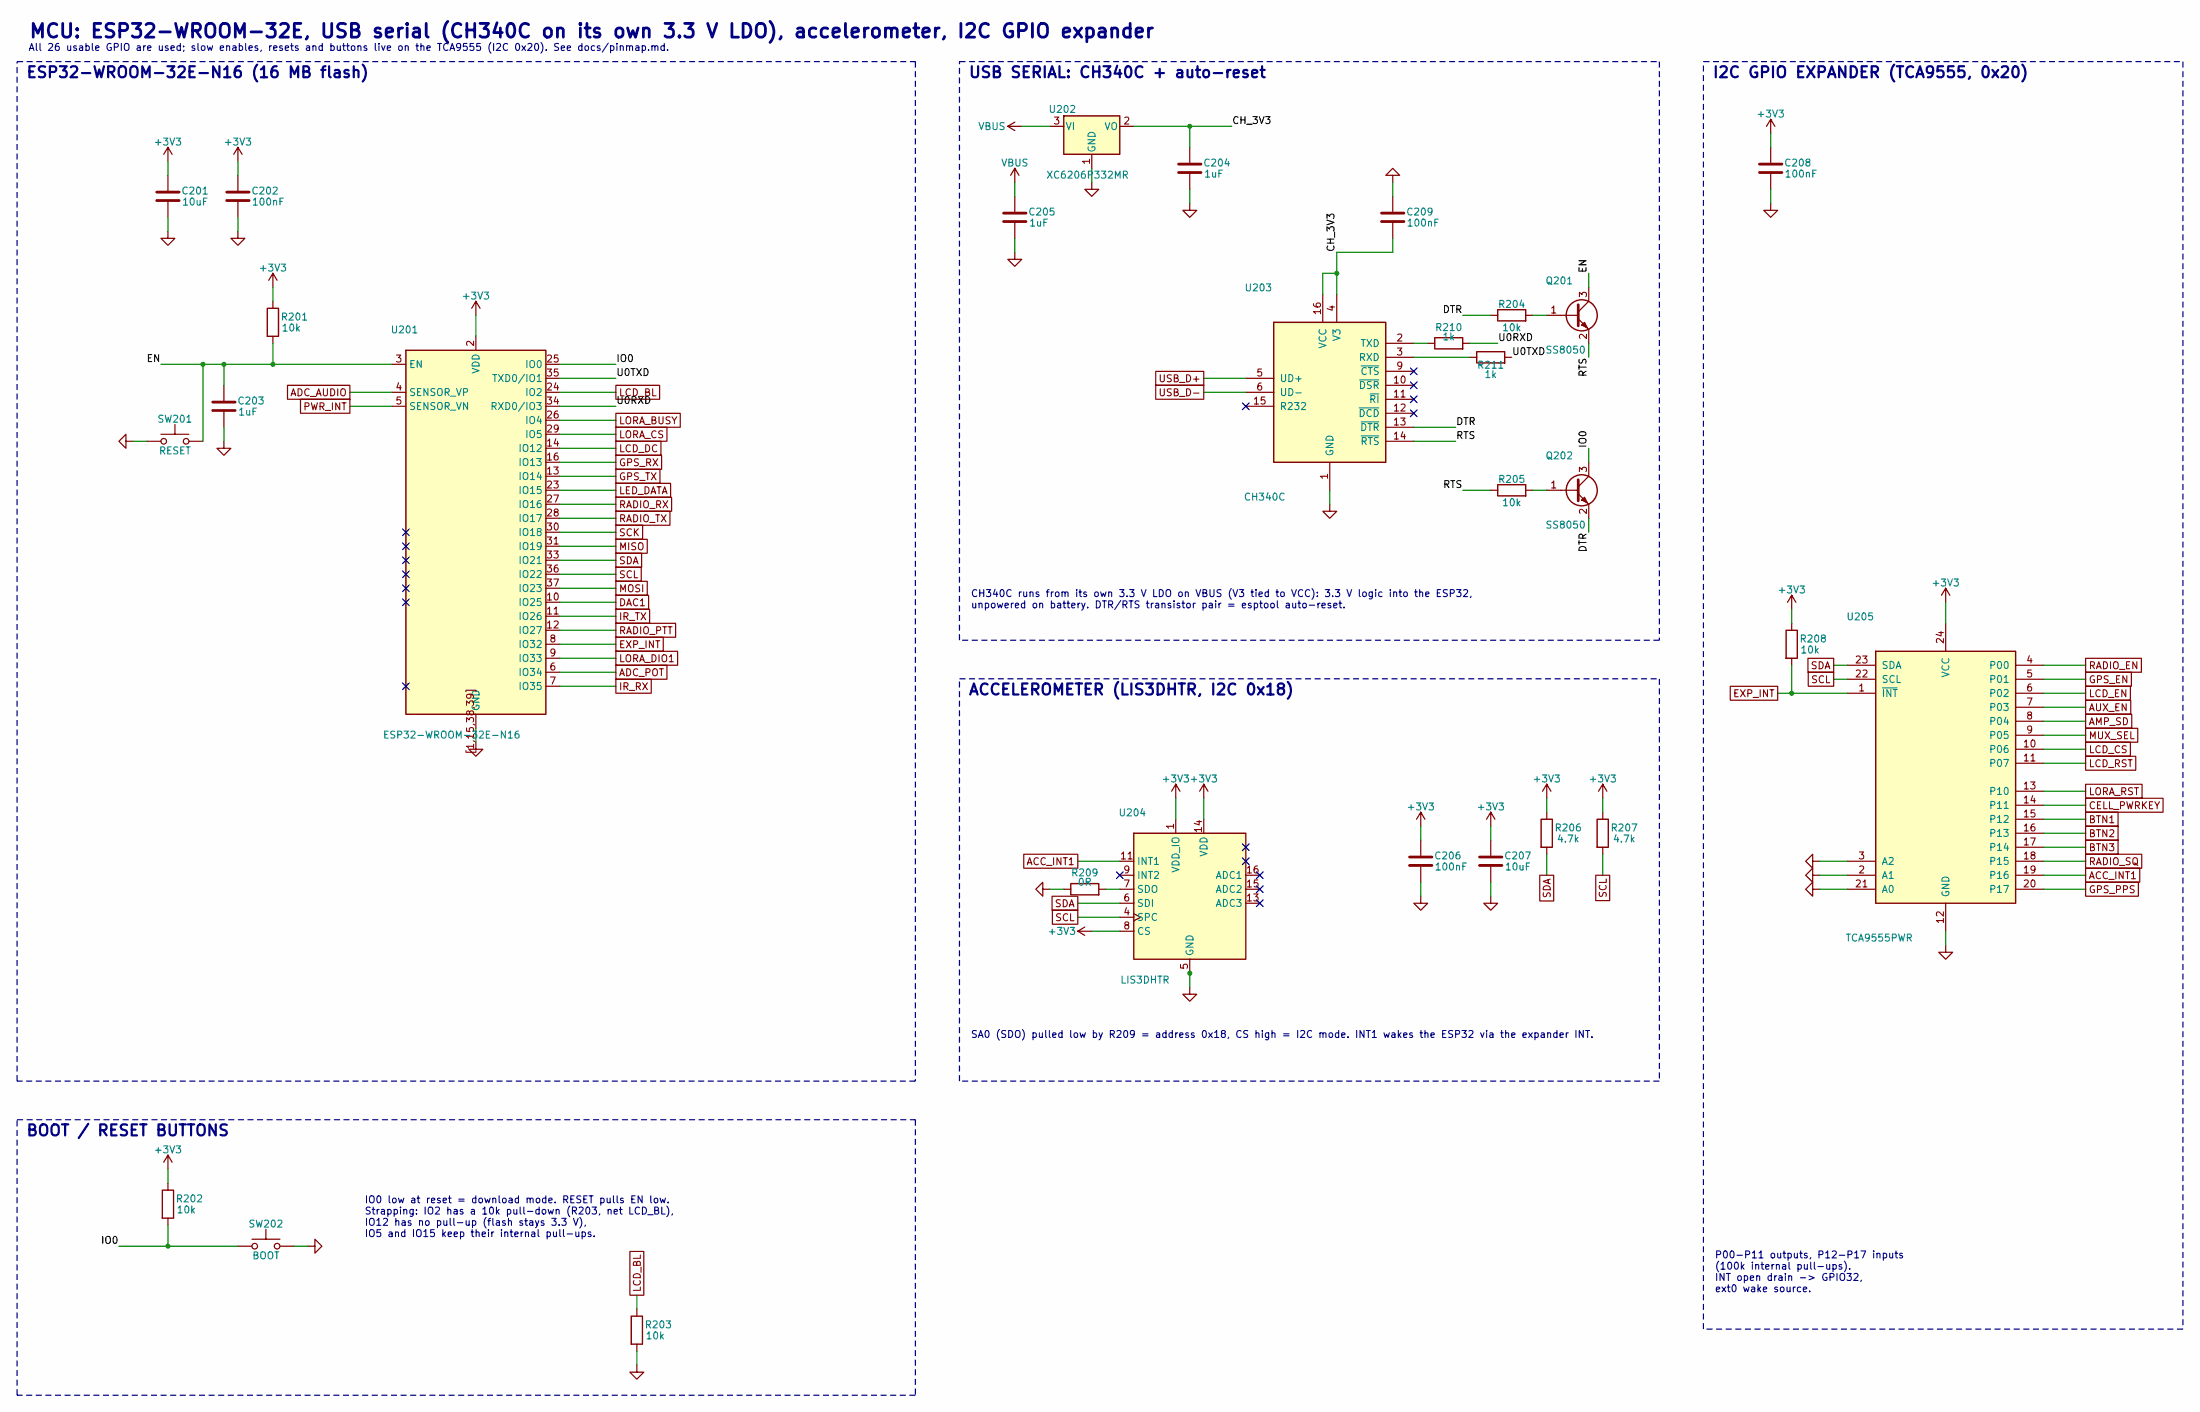
[picture p12: schematic mcu.kicad_sch]

Parts:
C201, C207: 10uF; C_0805_2012Metric; LCSC C15850
C202, C206, C208, C209: 100nF; C_0603_1608Metric; LCSC C14663
C203, C204, C205: 1uF; C_0603_1608Metric; LCSC C15849
Q201, Q202: SS8050; SOT-23; LCSC C2150
R201, R202, R203, R204, R205, R208: 10k; R_0603_1608Metric; LCSC C25804
R206, R207: 4.7k; R_0603_1608Metric; LCSC C23162
R209: 0R; R_0603_1608Metric; LCSC C21189
R210, R211: 1k; R_0603_1608Metric; LCSC C21190
SW201: RESET; SW_Push_1P1T_XKB_TS-1187A; LCSC C318884
SW202: BOOT; SW_Push_1P1T_XKB_TS-1187A; LCSC C318884
U201: ESP32-WROOM-32E-N16; ESP32-WROOM-32E; LCSC C701343
U202: XC6206P332MR; SOT-23-3; LCSC C5446
U203: CH340C; SOIC-16_3.9x9.9mm_P1.27mm; LCSC C84681
U204: LIS3DHTR; LGA-16_3x3mm_P0.5mm_LayoutBorder3x5y; LCSC C15134
U205: TCA9555PWR; TSSOP-24_4.4x7.8mm_P0.65mm; LCSC C465732

Connections:
+3V3: C201.1, C202.1, C206.1, C207.1, C208.1, R201.1, R202.1, R206.1, R207.1, R208.1, U201.2 (VDD), U204.1 (VDD_IO), U204.8 (CS), U204.14 (VDD), U205.24 (VCC)
ACC_INT1: U204.11 (INT1), U205.19 (P16)
ADC_AUDIO: U201.4 (SENSOR_VP)
ADC_POT: U201.6 (IO34)
AMP_SD: U205.8 (P04)
AUX_EN: U205.7 (P03)
BTN1: U205.15 (P12)
BTN2: U205.16 (P13)
BTN3: U205.17 (P14)
CELL_PWRKEY: U205.14 (P11)
CH_3V3: C204.1, C209.2, U202.2 (VO), U203.4 (V3), U203.16 (VCC)
DAC1: U201.10 (IO25)
DTR: Q202.2 (E), R204.1, U203.13 (~DTR)
EN: C203.1, Q201.3 (C), R201.2, SW201.2, U201.3 (EN)
EXP_INT: R208.2, U201.8 (IO32), U205.1 (~INT)
GND: C201.2, C202.2, C203.2, C204.2, C205.2, C206.2, C207.2, C208.2, C209.1, R203.2, R209.1, SW201.1, SW202.2, U201.[1,15,38,39] (GND), U202.1 (GND), U203.1 (GND), U204.5 (GND), U204.10 (GND), U204.12 (GND), U205.2 (A1), U205.3 (A2), U205.12 (GND), U205.21 (A0)
GPS_EN: U205.5 (P01)
GPS_PPS: U205.20 (P17)
GPS_RX: U201.16 (IO13)
GPS_TX: U201.13 (IO14)
IO0: Q202.3 (C), R202.2, SW202.1, U201.25 (IO0)
IR_RX: U201.7 (IO35)
IR_TX: U201.11 (IO26)
LCD_BL: R203.1, U201.24 (IO2)
LCD_CS: U205.10 (P06)
LCD_DC: U201.14 (IO12)
LCD_EN: U205.6 (P02)
LCD_RST: U205.11 (P07)
LED_DATA: U201.23 (IO15)
LORA_BUSY: U201.26 (IO4)
LORA_CS: U201.29 (IO5)
LORA_DIO1: U201.9 (IO33)
LORA_RST: U205.13 (P10)
MISO: U201.31 (IO19)
MOSI: U201.37 (IO23)
MUX_SEL: U205.9 (P05)
unnamed: Q201.1 (B), R204.2
unnamed: Q202.1 (B), R205.2
unnamed: R209.2, U204.7 (SDO)
unnamed: R210.1, U203.2 (TXD)
unnamed: R211.1, U203.3 (RXD)
PWR_INT: U201.5 (SENSOR_VN)
RADIO_EN: U205.4 (P00)
RADIO_PTT: U201.12 (IO27)
RADIO_RX: U201.27 (IO16)
RADIO_SQ: U205.18 (P15)
RADIO_TX: U201.28 (IO17)
RTS: Q201.2 (E), R205.1, U203.14 (~RTS)
SCK: U201.30 (IO18)
SCL: R207.2, U201.36 (IO22), U204.4 (SPC), U205.22 (SCL)
SDA: R206.2, U201.33 (IO21), U204.6 (SDI), U205.23 (SDA)
U0RXD: R210.2, U201.34 (RXD0/IO3)
U0TXD: R211.2, U201.35 (TXD0/IO1)
USB_D+: U203.5 (UD+)
USB_D-: U203.6 (UD-)
VBUS: C205.1, U202.3 (VI)

Notes on the sheet:
MCU: ESP32-WROOM-32E, USB serial (CH340C on its own 3.3 V LDO), accelerometer, I2C GPIO expander
All 26 usable GPIO are used; slow enables, resets and buttons live on the TCA9555 (I2C 0x20). See docs/pinmap.md.
ESP32-WROOM-32E-N16 (16 MB flash)
BOOT / RESET BUTTONS
IO0 low at reset = download mode. RESET pulls EN low. Strapping: IO2 has a 10k pull-down (R203, net LCD_BL), IO12 has no pull-up (flash stays 3.3 V), IO5 and IO15 keep their internal pull-ups.
USB SERIAL: CH340C + auto-reset
CH340C runs from its own 3.3 V LDO on VBUS (V3 tied to VCC): 3.3 V logic into the ESP32, unpowered on battery. DTR/RTS transistor pair = esptool auto-reset.
ACCELEROMETER (LIS3DHTR, I2C 0x18)
SA0 (SDO) pulled low by R209 = address 0x18, CS high = I2C mode. INT1 wakes the ESP32 via the expander INT.
I2C GPIO EXPANDER (TCA9555, 0x20)
P00-P11 outputs, P12-P17 inputs (100k internal pull-ups). INT open drain -> GPIO32, ext0 wake source.
