7kasper/LazerGamebox/hardware/power.kicad_sch

## KiCad design hardware/power.kicad_sch (2026-09-29)

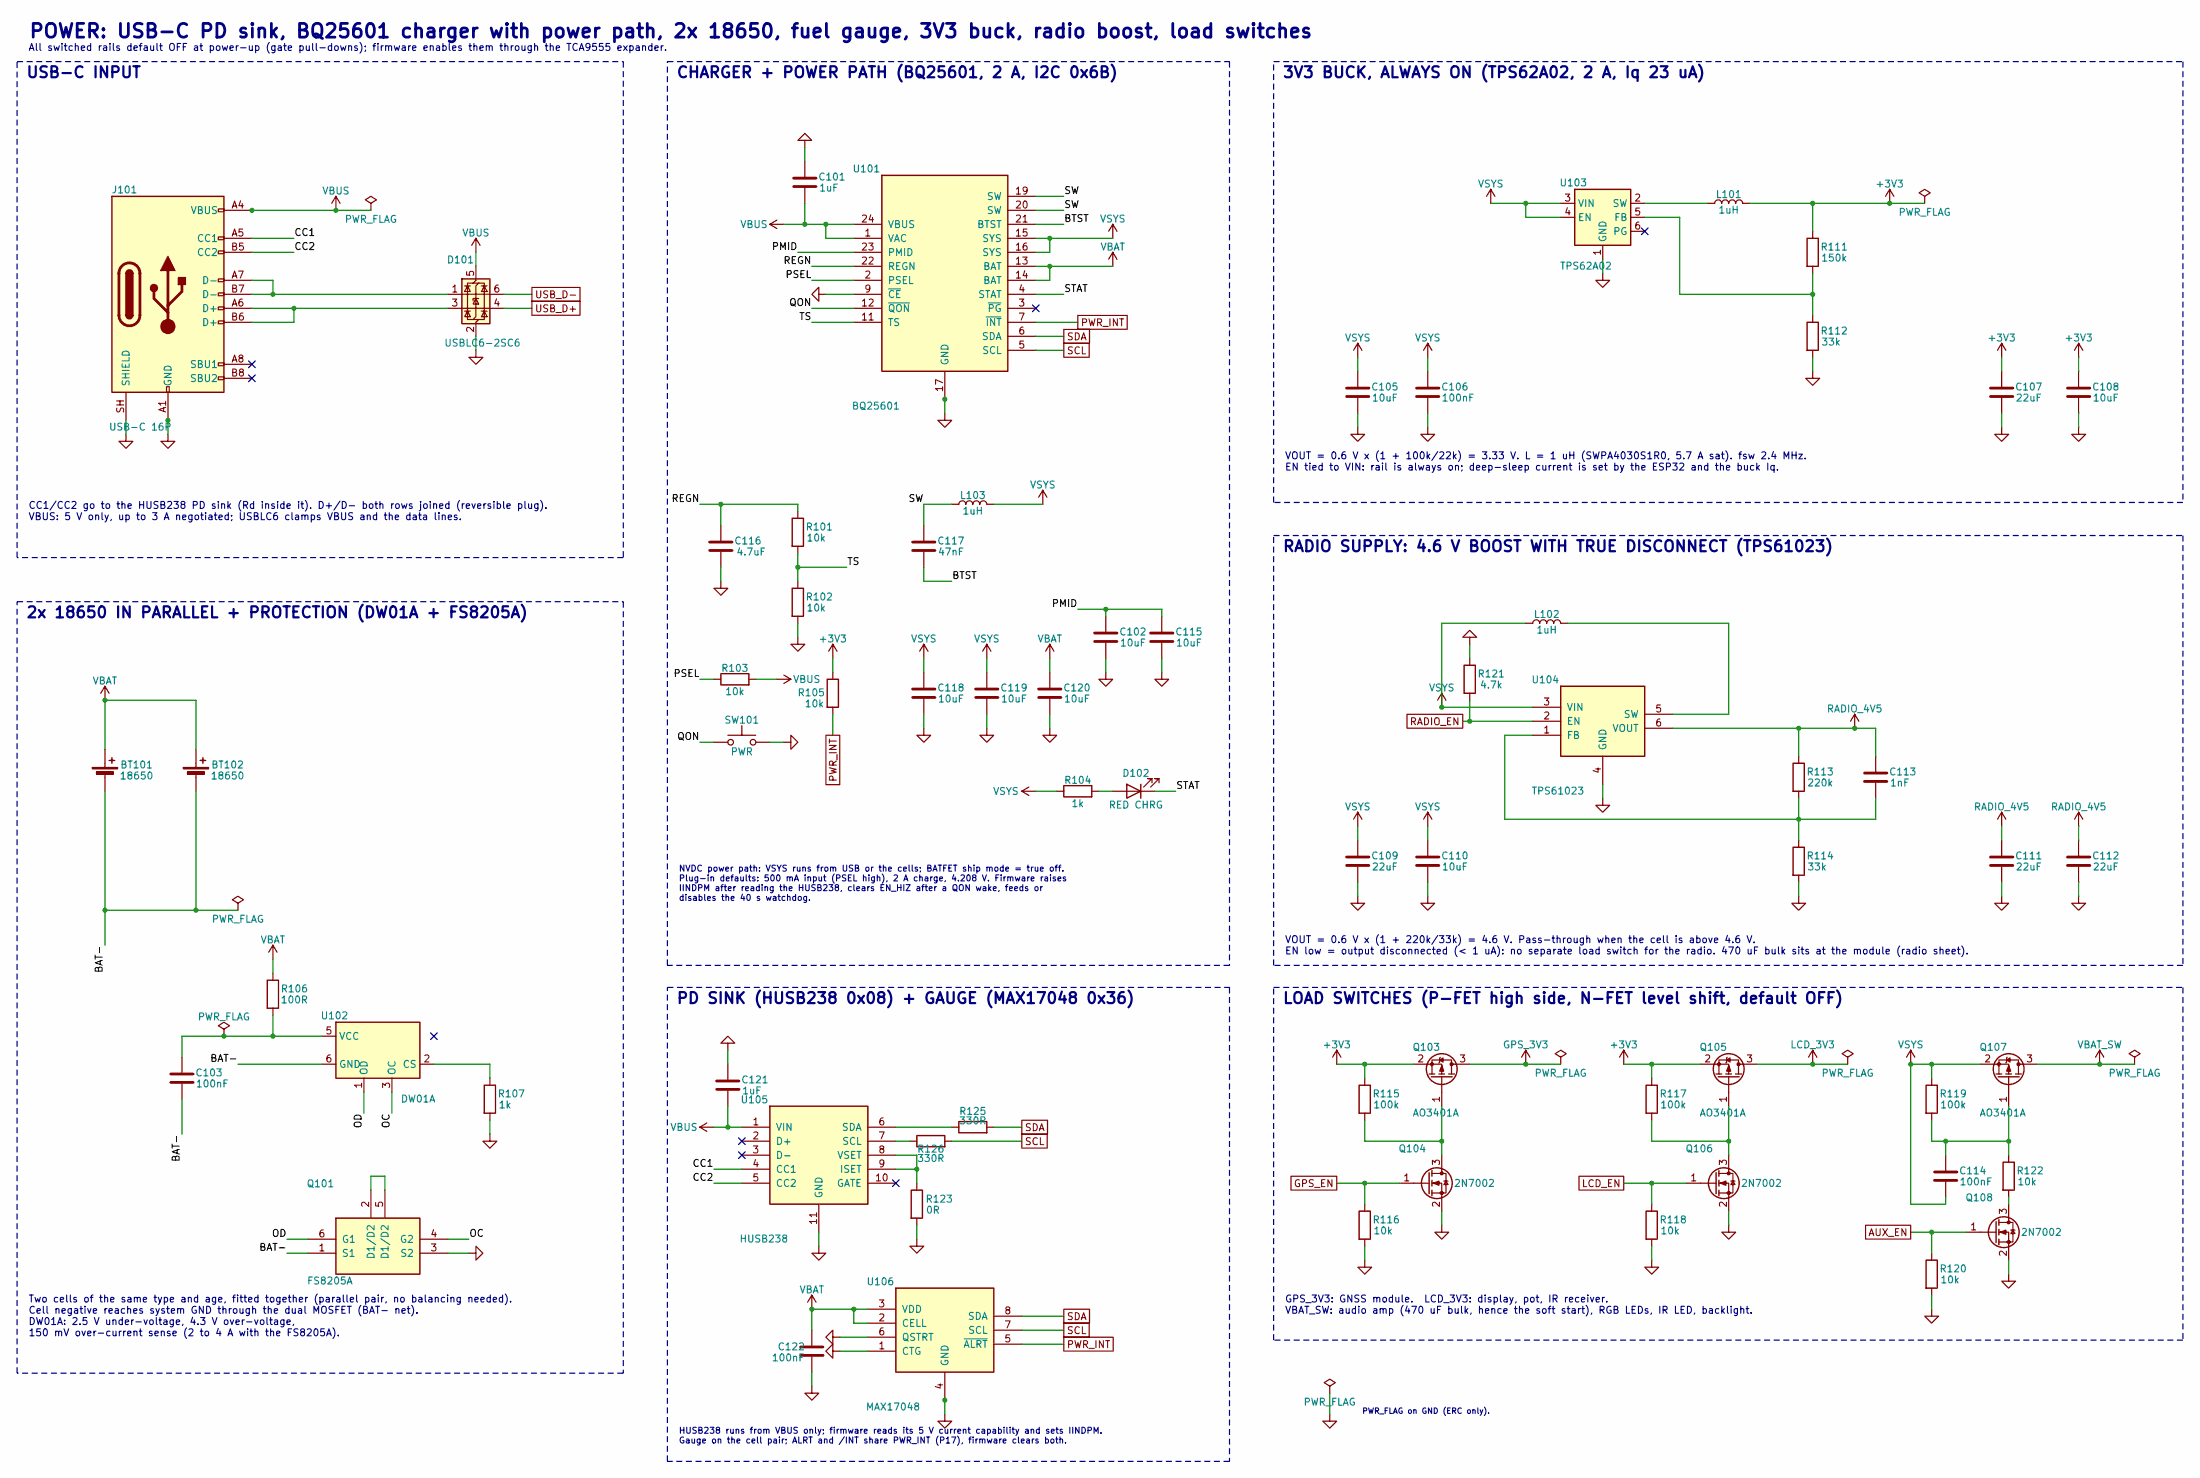
[picture p13: schematic power.kicad_sch]

Parts:
BT101, BT102: 18650; BATTERY-SMD_18650-1S-L77.1-W20.7-1; LCSC C2988620
C101, C121: 1uF; C_0603_1608Metric; LCSC C15849
C102, C105, C108, C110, C115, C118, C119, C120: 10uF; C_0805_2012Metric; LCSC C15850
C103, C106, C114, C122: 100nF; C_0603_1608Metric; LCSC C14663
C107, C109, C111, C112: 22uF; C_0805_2012Metric; LCSC C45783
C113: 1nF; C_0603_1608Metric; LCSC C1588
C116: 4.7uF; C_0603_1608Metric; LCSC C19666
C117: 47nF; C_0603_1608Metric; LCSC C1622
D101: USBLC6-2SC6; SOT-23-6; LCSC C7519
D102: RED CHRG; LED_0603_1608Metric; LCSC C2286
J101: USB-C 16P; USB_C_Receptacle_HRO_TYPE-C-31-M-12; LCSC C165948
L101, L102, L103: 1uH; L_Sunlord_SWPA4030S; LCSC C42193
Q101: FS8205A; SOT-23-6; LCSC C908265
Q103, Q105, Q107: AO3401A; SOT-23; LCSC C15127
Q104, Q106, Q108: 2N7002; SOT-23; LCSC C8545
R101, R102, R103, R105, R116, R118, R120, R122: 10k; R_0603_1608Metric; LCSC C25804
R104, R107: 1k; R_0603_1608Metric; LCSC C21190
R106: 100R; R_0603_1608Metric; LCSC C22775
R111: 150k; R_0603_1608Metric; LCSC C22807
R112, R114: 33k; R_0603_1608Metric; LCSC C4216
R113: 220k; R_0603_1608Metric; LCSC C22961
R115, R117, R119: 100k; R_0603_1608Metric; LCSC C25803
R121: 4.7k; R_0603_1608Metric; LCSC C23162
R123: 0R; R_0603_1608Metric; LCSC C21189
R125, R126: 330R; R_0603_1608Metric; LCSC C23138
SW101: PWR; SW_Push_1P1T_XKB_TS-1187A; LCSC C318884
U101: BQ25601; VFQFPN-24_L4.0-W4.0-P0.50-BL-EP2.8; LCSC C468236
U102: DW01A; SOT-23-6; LCSC C351410
U103: TPS62A02; SOT-563; LCSC C5350187
U104: TPS61023; SOT-563; LCSC C919459
U105: HUSB238; DFN-10_L3.0-W3.0-P0.50-BL-EP2.5; LCSC C7471904
U106: MAX17048; TDFN-8_L2.0-W2.0-P0.50-BL-EP1.2; LCSC C2682616

Connections:
+3V3: C107.1, C108.1, L101.2, Q103.2 (S), Q105.2 (S), R105.1, R111.1, R115.1, R117.1
AUX_EN: Q108.1 (G), R120.1
BAT-: BT101.2 (-), BT102.2 (-), C103.2, Q101.1 (S1), U102.6 (GND)
BTST: C117.2, U101.21 (BTST)
CC1: J101.A5 (CC1), U105.4 (CC1)
CC2: J101.B5 (CC2), U105.5 (CC2)
GND: C101.1, C102.2, C105.2, C106.2, C107.2, C108.2, C109.2, C110.2, C111.2, C112.2, C115.2, C116.2, C118.2, C119.2, C120.2, C121.1, C122.2, D101.2 (GND), J101.A1 (GND), J101.A12 (GND), J101.B1 (GND), J101.B12 (GND), J101.SH (SHIELD), Q101.3 (S2), Q104.2 (S), Q106.2 (S), Q108.2 (S), R102.2, R107.2, R112.2, R114.2, R116.2, R118.2, R120.2, R121.1, R123.2, SW101.2, U101.9 (~CE), U101.17 (GND), U101.18 (GND), U101.25 (GND), U103.1 (GND), U104.4 (GND), U105.11 (GND), U106.1 (CTG), U106.4 (GND), U106.6 (QSTRT), U106.9 (GND)
GPS_3V3: Q103.3 (D)
GPS_EN: Q104.1 (G), R116.1
LCD_3V3: Q105.3 (D)
LCD_EN: Q106.1 (G), R118.1
unnamed: C103.1, R106.2, U102.5 (VCC)
unnamed: C113.2, R113.2, R114.1, U104.1 (FB)
unnamed: C114.1, Q107.1 (G), R119.2, R122.1
unnamed: D101.1 (I/O1), J101.A7 (D-), J101.B7 (D-)
unnamed: D101.3 (I/O2), J101.A6 (D+), J101.B6 (D+)
unnamed: D102.2 (A), R104.2
unnamed: L101.1, U103.2 (SW)
unnamed: L102.2, U104.5 (SW)
unnamed: Q101.2 (D1/D2), Q101.5 (D1/D2)
unnamed: Q103.1 (G), Q104.3 (D), R115.2
unnamed: Q105.1 (G), Q106.3 (D), R117.2
unnamed: Q108.3 (D), R122.2
unnamed: R107.1, U102.2 (CS)
unnamed: R111.2, R112.1, U103.5 (FB)
unnamed: R123.1, U105.8 (VSET), U105.9 (ISET)
unnamed: R125.1, U105.6 (SDA)
unnamed: R126.1, U105.7 (SCL)
OC: Q101.4 (G2), U102.3 (OC)
OD: Q101.6 (G1), U102.1 (OD)
PMID: C102.1, C115.1, U101.23 (PMID)
PSEL: R103.1, U101.2 (PSEL)
PWR_INT: R105.2, U101.7 (~INT), U106.5 (~ALRT)
QON: SW101.1, U101.12 (~QON)
RADIO_4V5: C111.1, C112.1, C113.1, R113.1, U104.6 (VOUT)
RADIO_EN: R121.2, U104.2 (EN)
REGN: C116.1, R101.1, U101.22 (REGN)
SCL: R126.2, U101.5 (SCL), U106.7 (SCL)
SDA: R125.2, U101.6 (SDA), U106.8 (SDA)
STAT: D102.1 (K), U101.4 (STAT)
SW: C117.1, L103.1, U101.19 (SW), U101.20 (SW)
TS: R101.2, R102.1, U101.11 (TS)
USB_D+: D101.4 (I/O2)
USB_D-: D101.6 (I/O1)
VBAT: BT101.1 (+), BT102.1 (+), C120.1, C122.1, R106.1, U101.13 (BAT), U101.14 (BAT), U106.2 (CELL), U106.3 (VDD)
VBAT_SW: Q107.3 (D)
VBUS: C101.2, C121.2, D101.5 (VBUS), J101.A4 (VBUS), J101.A9 (VBUS), J101.B4 (VBUS), J101.B9 (VBUS), R103.2, U101.1 (VAC), U101.24 (VBUS), U105.1 (VIN)
VSYS: C105.1, C106.1, C109.1, C110.1, C114.2, C118.1, C119.1, L102.1, L103.2, Q107.2 (S), R104.1, R119.1, U101.15 (SYS), U101.16 (SYS), U103.3 (VIN), U103.4 (EN), U104.3 (VIN)

Notes on the sheet:
POWER: USB-C PD sink, BQ25601 charger with power path, 2x 18650, fuel gauge, 3V3 buck, radio boost, load switches
All switched rails default OFF at power-up (gate pull-downs); firmware enables them through the TCA9555 expander.
USB-C INPUT
CC1/CC2 go to the HUSB238 PD sink (Rd inside it). D+/D- both rows joined (reversible plug). VBUS: 5 V only, up to 3 A negotiated; USBLC6 clamps VBUS and the data lines.
CHARGER + POWER PATH (BQ25601, 2 A, I2C 0x6B)
NVDC power path: VSYS runs from USB or the cells; BATFET ship mode = true off. Plug-in defaults: 500 mA input (PSEL high), 2 A charge, 4.208 V. Firmware raises IINDPM after reading the HUSB238, clears EN_HIZ after a QON wake, feeds or disables the 40 s watchdog.
2x 18650 IN PARALLEL + PROTECTION (DW01A + FS8205A)
Two cells of the same type and age, fitted together (parallel pair, no balancing needed). Cell negative reaches system GND through the dual MOSFET (BAT- net). DW01A: 2.5 V under-voltage, 4.3 V over-voltage, 150 mV over-current sense (2 to 4 A with the FS8205A).
PD SINK (HUSB238 0x08) + GAUGE (MAX17048 0x36)
HUSB238 runs from VBUS only; firmware reads its 5 V current capability and sets IINDPM. Gauge on the cell pair; ALRT and /INT share PWR_INT (P17), firmware clears both.
3V3 BUCK, ALWAYS ON (TPS62A02, 2 A, Iq 23 uA)
VOUT = 0.6 V x (1 + 100k/22k) = 3.33 V. L = 1 uH (SWPA4030S1R0, 5.7 A sat). fsw 2.4 MHz. EN tied to VIN: rail is always on; deep-sleep current is set by the ESP32 and the buck Iq.
RADIO SUPPLY: 4.6 V BOOST WITH TRUE DISCONNECT (TPS61023)
VOUT = 0.6 V x (1 + 220k/33k) = 4.6 V. Pass-through when the cell is above 4.6 V. EN low = output disconnected (< 1 uA): no separate load switch for the radio. 470 uF bulk sits at the module (radio sheet).
LOAD SWITCHES (P-FET high side, N-FET level shift, default OFF)
GPS_3V3: GNSS module. LCD_3V3: display, pot, IR receiver. VBAT_SW: audio amp (470 uF bulk, hence the soft start), RGB LEDs, IR LED, backlight.
PWR_FLAG on GND (ERC only).
