7kasper/LazerGamebox/hardware/radio.kicad_sch

## KiCad design hardware/radio.kicad_sch (2026-09-29)

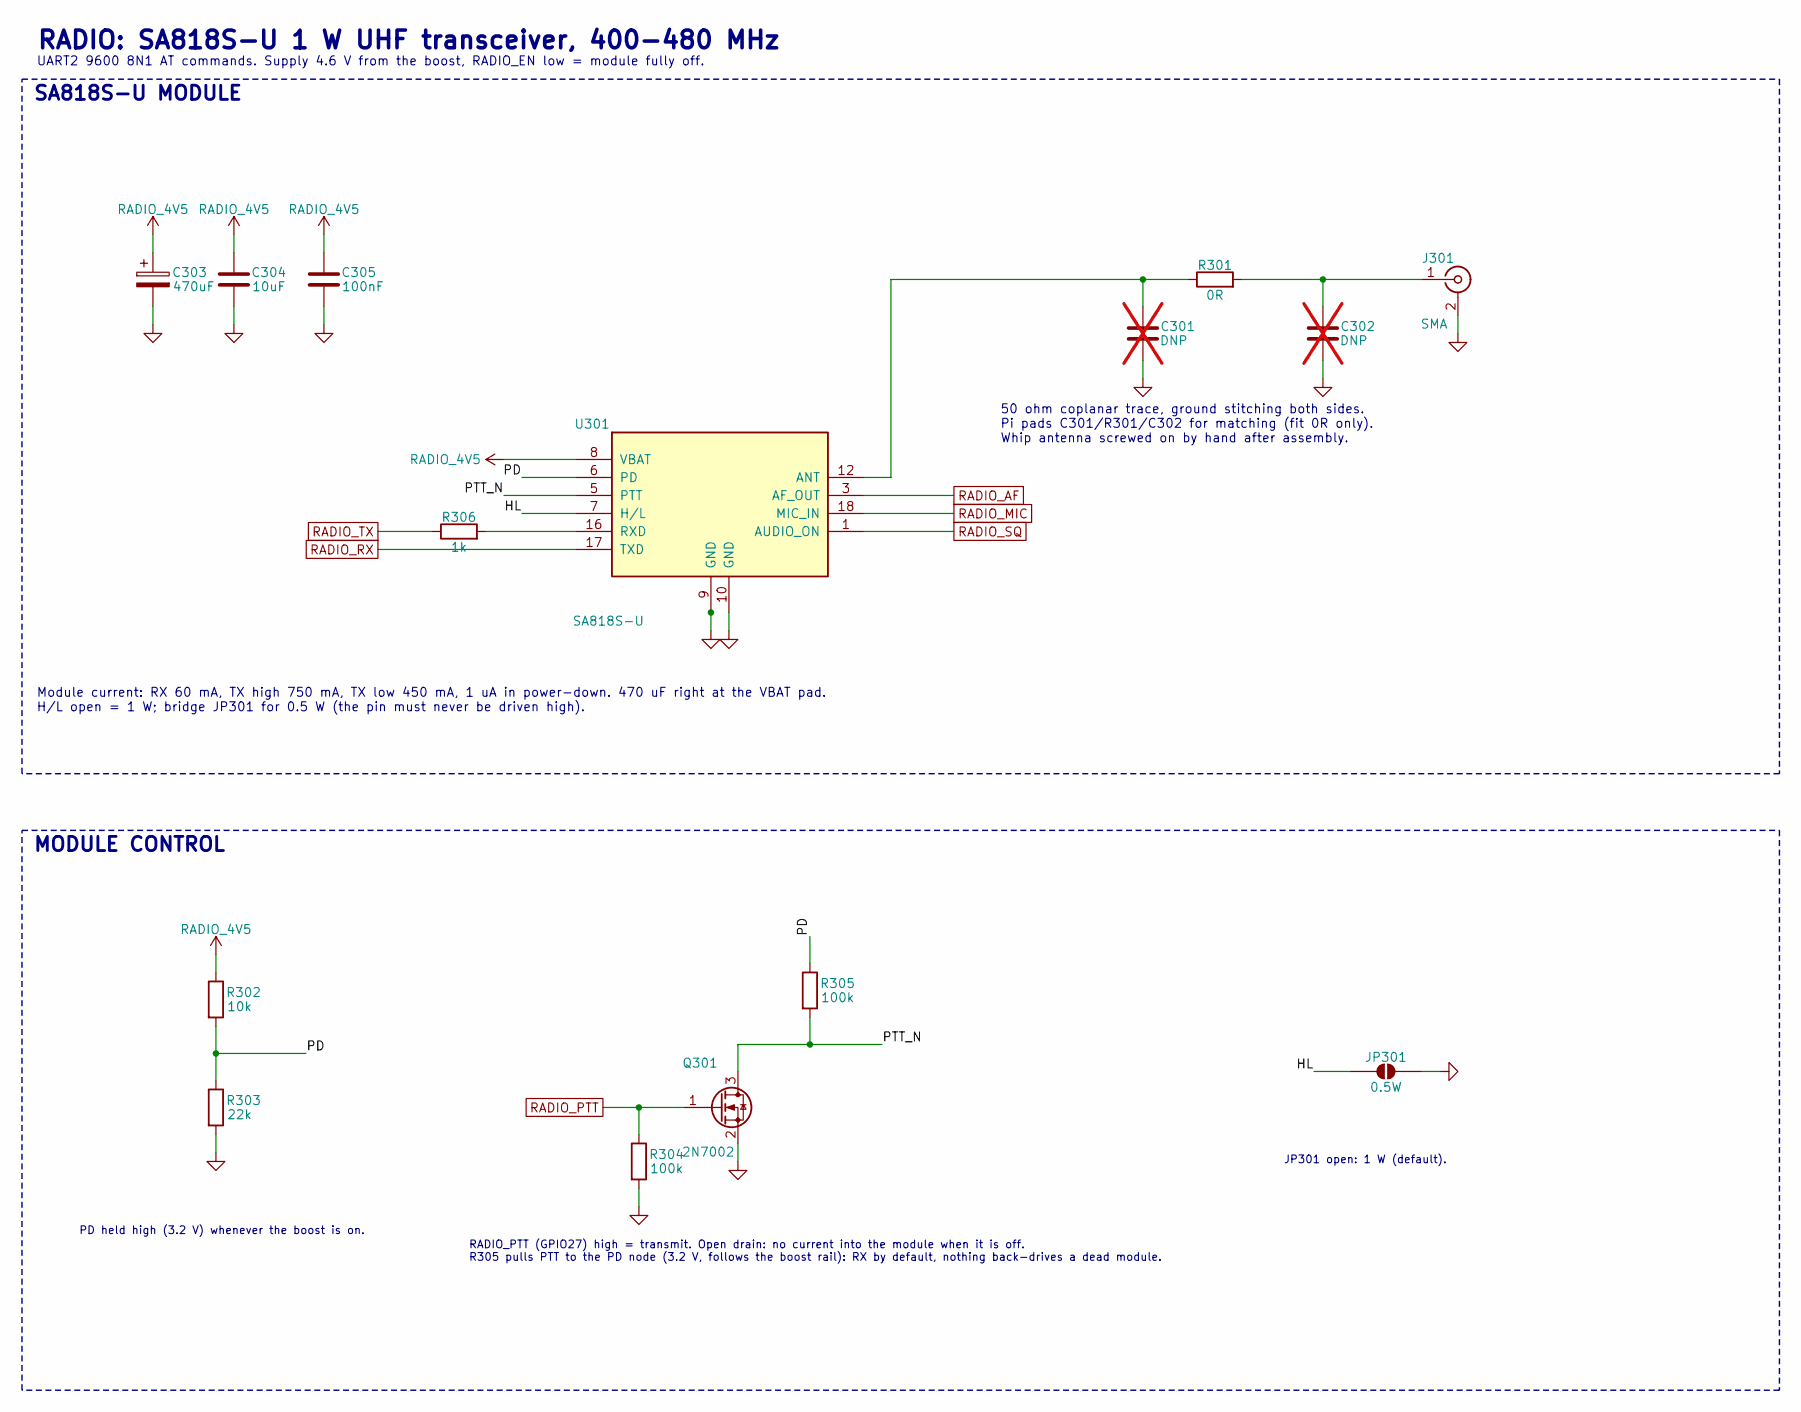
[picture p14: schematic radio.kicad_sch]

Parts:
C301, C302: DNP; C_0603_1608Metric; not fitted
C303: 470uF; CP_Elec_6.3x7.7; LCSC C2858856
C304: 10uF; C_0805_2012Metric; LCSC C15850
C305: 100nF; C_0603_1608Metric; LCSC C14663
J301: SMA; SMA_BAT_Wireless_BWSMA-KWE-Z001; LCSC C496551
JP301: 0.5W; SolderJumper-2_P1.3mm_Open_RoundedPad1.0x1.5mm
Q301: 2N7002; SOT-23; LCSC C8545
R301: 0R; R_0603_1608Metric; LCSC C21189
R302: 10k; R_0603_1608Metric; LCSC C25804
R303: 22k; R_0603_1608Metric; LCSC C31850
R304, R305: 100k; R_0603_1608Metric; LCSC C25803
R306: 1k; R_0603_1608Metric; LCSC C21190
U301: SA818S-U; WIRELM-SMD_G-NICERF_SA818S-X; LCSC C3001549

Connections:
GND: C301.2, C302.2, C303.2, C304.2, C305.2, J301.2 (Ext), JP301.2 (B), Q301.2 (S), R303.2, R304.2, U301.9 (GND), U301.10 (GND), U301.19 (GND), U301.20 (GND)
HL: JP301.1 (A), U301.7 (H/L)
unnamed: C301.1, R301.1, U301.12 (ANT)
unnamed: C302.1, J301.1 (In), R301.2
unnamed: R306.2, U301.16 (RXD)
PD: R302.2, R303.1, R305.1, U301.6 (PD)
PTT_N: Q301.3 (D), R305.2, U301.5 (PTT)
RADIO_4V5: C303.1, C304.1, C305.1, R302.1, U301.8 (VBAT)
RADIO_AF: U301.3 (AF_OUT)
RADIO_MIC: U301.18 (MIC_IN)
RADIO_PTT: Q301.1 (G), R304.1
RADIO_RX: U301.17 (TXD)
RADIO_SQ: U301.1 (AUDIO_ON)
RADIO_TX: R306.1

Notes on the sheet:
RADIO: SA818S-U 1 W UHF transceiver, 400-480 MHz
UART2 9600 8N1 AT commands. Supply 4.6 V from the boost, RADIO_EN low = module fully off.
SA818S-U MODULE
50 ohm coplanar trace, ground stitching both sides. Pi pads C301/R301/C302 for matching (fit 0R only). Whip antenna screwed on by hand after assembly.
Module current: RX 60 mA, TX high 750 mA, TX low 450 mA, 1 uA in power-down. 470 uF right at the VBAT pad. H/L open = 1 W; bridge JP301 for 0.5 W (the pin must never be driven high).
MODULE CONTROL
PD held high (3.2 V) whenever the boost is on.
RADIO_PTT (GPIO27) high = transmit. Open drain: no current into the module when it is off. R305 pulls PTT to the PD node (3.2 V, follows the boost rail): RX by default, nothing back-drives a dead module.
JP301 open: 1 W (default).
