7kasper/LazerGamebox/(commit log)

2026-09-29 Schematic conjure-up with Claude
    [LazerGamebox.kicad_sch, audio.kicad_sch, bom_preview.csv, io.kicad_sch, lora_gps.kicad_sch, mcu.kicad_sch, power.kicad_sch, radio.kicad_sch]
2026-09-29 Add more IO
    [LazerGamebox.kicad_sch, audio.kicad_sch, bom_preview.csv, io.kicad_sch, lora_gps.kicad_sch, mcu.kicad_sch, power.kicad_sch, radio.kicad_sch]
2026-09-29 Added microphone to the unit
    [LazerGamebox.kicad_sch, audio.kicad_sch, bom_preview.csv, io.kicad_sch, lora_gps.kicad_sch, mcu.kicad_sch, power.kicad_sch, radio.kicad_sch]
